alebeierbach/Proyecto-Integrador-PI/README.md

<h1 align="center"><strong>Proyecto Integrador (Tesis)</strong><br></h1>

<p align="center">
  <em>Universidad Nacional de Córdoba</em>
</p>

El trabajo consiste en el diseño e implementación de un prototipo de granja urbana vertical
inteligente a escala reducida, con tres niveles de cultivo en sustrato. El sistema contará con sensado
ambiental (temperatura, humedad, luz), riego por goteo con recirculación, iluminación LED full
espectro, ventilación activa y sistemas para el control de los factores ambientales (sol, lluvia, frío,
calor). El control se realizará mediante microcontrolador, con adquisición y análisis de datos,
orientado a mejorar la eficiencia hídrica y energética.
