alebeierbach/Proyecto-Integrador-PI/Informe/portada.tex

\thispagestyle{empty}

\begin{center}
UNIVERSIDAD NACIONAL DE CÓRDOBA\\
FACULTAD DE CIENCIAS EXACTAS, FÍSICAS Y NATURALES\\
CARRERA INGENIERÍA ELECTRÓNICA\\[2cm]

PROYECTO INTEGRADOR PARA LA OBTENCIÓN DEL TÍTULO DE GRADO\\
INGENIERO ELECTRÓNICO\\[2cm]

{\bfseries\MakeUppercase{\tituloPI}}\\[2cm]

Alumno/s\\
\alumnoA\\
\alumnoB\\[1cm]

Director\\
\directorPI\\[1cm]

Co-Director\\
\codirectorPI\\[2cm]

Córdoba, República Argentina\\
\mesanio
\end{center}
