alebeierbach/Proyecto-Integrador-PI/Informe/anexos/anexo_1.tex

\chapter{Anexo I}
\label{anexo1}

\section*{Título}
\addcontentsline{toc}{section}{Anexo I - Título}

Aquí se incluye material complementario: desarrollos extensos, tablas auxiliares, hojas de datos, código, etc.
