alebeierbach/Proyecto-Integrador-PI/Informe/anexos/anexo_2.tex

\chapter{Anexo II}
\label{anexo2}

\section*{Título}
\addcontentsline{toc}{section}{Anexo II - Título}

Aquí puede incluirse material complementario adicional.
