alebeierbach/Proyecto-Integrador-PI/Informe/paginas/abstract.tex

\chapter*{Abstract}
\addcontentsline{toc}{chapter}{Abstract}

This section must contain the English version of the summary. It should clearly explain the scope of the work, the methodology employed and the general content of the Project. It must not include personal judgments, criticism or interpretations.

\vspace{1cm}

\noindent\textbf{Thematic area:} Communications, Analog electronics

\vspace{0.5cm}

\noindent\textbf{Subjects:} Analog Electronics III, Communications, Electronic Instrumentation

\vspace{0.5cm}

\noindent\textbf{Key words:} tuned filter, impedance matching, resonant circuit, experimental measurements, simulation
