alebeierbach/Proyecto-Integrador-PI/Informe/paginas/director.tex

\thispagestyle{empty}

\begin{center}
UNIVERSIDAD NACIONAL DE CÓRDOBA\\
Facultad de Ciencias Exactas, Físicas y Naturales\\
Escuela de Ingeniería Electrónica
\end{center}

\vspace{1.5cm}

Quien suscribe el Profesor \textbf{COMPLETAR TODOS LOS CAMPOS}, en su carácter de Director del Proyecto Integrador del Estudiante \textbf{COMPLETAR}, denominado:

\vspace{0.5cm}

\begin{center}
\textbf{\tituloPI}
\end{center}

\vspace{0.5cm}

considera que el desarrollo del trabajo se ha completado según lo especificado en la Solicitud de Aprobación de Tema y se encuentra en condiciones de tramitar su defensa.

\vspace{1cm}

A los efectos de quien corresponda, en fecha \underline{\hspace{1cm}}/\underline{\hspace{1cm}}/\underline{\hspace{1cm}}.

\vspace{4cm}

\begin{flushright}
Firma y aclaración del Director
\end{flushright}
