alebeierbach/Proyecto-Integrador-PI/Informe/paginas/lista_simbolos.tex

\chapter*{Lista de símbolos y convenciones}
\addcontentsline{toc}{chapter}{Lista de símbolos y convenciones}

\begin{longtable}{p{3cm} p{10cm}}
$f_0$ & Frecuencia de resonancia o frecuencia central. \\
$BW$ & Ancho de banda. \\
$Q$ & Factor de calidad. \\
$R_g$ & Resistencia del generador o resistencia de entrada. \\
$R_L$ & Resistencia de carga. \\
$L$ & Inductancia. \\
$C$ & Capacitancia. \\
$X_L$ & Reactancia inductiva. \\
$X_C$ & Reactancia capacitiva. \\
\end{longtable}
