alebeierbach/Proyecto-Integrador-PI/Informe/paginas/resumen.tex

\chapter*{Resumen}
\addcontentsline{toc}{chapter}{Resumen}

Este apartado debe contener una descripción clara y concreta del alcance del trabajo. Con su lectura, el lector debe comprender de qué trata el Proyecto Integrador, cómo fue desarrollado y qué aspectos principales aborda. El resumen no debe incluir juicios de valor, interpretaciones ni críticas. Debe tener menos de 400 palabras.

\vspace{1cm}

\noindent\textbf{Área temática:} Comunicaciones, Analógica

\vspace{0.5cm}

\noindent\textbf{Asignaturas:} Electrónica Analógica III, Comunicaciones, Instrumentación Electrónica

\vspace{0.5cm}

\noindent\textbf{Palabras claves:} filtro sintonizado, adaptación de impedancias, circuito resonante, mediciones experimentales, simulación
