alebeierbach/Proyecto-Integrador-PI/Informe/paginas/resumo.tex

\chapter*{Resumo}
\addcontentsline{toc}{chapter}{Resumo}

Esta seção deve conter a versão em português do resumo. O texto deve informar claramente o alcance do trabalho, a metodologia utilizada e os principais aspectos do Projeto Integrador.

\vspace{1cm}

\noindent\textbf{Área temática:} Comunicações, Analógica

\vspace{0.5cm}

\noindent\textbf{Assuntos:} Eletrônica Analógica III, Comunicações, Instrumentação Eletrônica

\vspace{0.5cm}

\noindent\textbf{Palavras chaves:} filtro sintonizado, adaptação de impedâncias, circuito ressonante, medições experimentais, simulação
