alebeierbach/Proyecto-Integrador-PI/Informe/paginas/tribunal.tex

\thispagestyle{empty}

\begin{center}
UNIVERSIDAD NACIONAL DE CÓRDOBA\\
Facultad de Ciencias Exactas, Físicas y Naturales\\
Escuela de Ingeniería Electrónica
\end{center}

\vspace{1.5cm}

El Tribunal Evaluador reunido en este acto y luego de haber aprobado la Solicitud de Aprobación de Tema y efectuado las distintas instancias de correcciones del Informe del Proyecto Integrador para la obtención del Título de Grado ``Ingeniero Electrónico'' y cumpliendo con el Reglamento correspondiente, declaran el Informe Final de/l los estudiante/s: \textbf{COMPLETAR} como ``aceptado sin correcciones'' y la defensa oral aprobada.

Por lo tanto, luego de haber tenido en cuenta los aspectos de evaluación que indica el Reglamento, el Proyecto Integrador se considera aprobado.

\vspace{1cm}

Se firma el Acta de Examen correspondiente y se distribuyen los ejemplares impresos.

\vspace{2cm}

\noindent NOTA:

\vspace{3cm}

\begin{flushright}
Firma y aclaración del Tribunal Evaluador

\vspace{1cm}
Fecha:
\end{flushright}
