alebeierbach/Proyecto-Integrador-PI/Informe/secciones/referencias.tex

\chapter*{Referencias}
\addcontentsline{toc}{chapter}{Referencias}

Aquí van todas las referencias que no sean libros: sitios web, apuntes, hojas de datos, documentación técnica, normas, herramientas de IA, etc.

\begin{thebibliography}{99}

\bibitem{ejemplorecurso} Autor o institución. \textit{Título del recurso}. Recuperado de: URL. Fecha de acceso: dd/mm/aaaa.

\bibitem{openai2026} OpenAI. (2026). ChatGPT \textnormal{[modelo de inteligencia artificial]. Recuperado de: https://openai.com/. Consulta realizada para asistencia de redacción y estructura del documento. Prompt utilizado: "COMPLETAR CON LO QUE SE PREGUNTÓ".}

\bibitem{ejemplodatasheet} Fabricante. \textit{Nombre de la hoja de datos}. Recuperado de: URL. Fecha de acceso: dd/mm/aaaa.

\bibitem{roosteralex2022} roosteralex8214 (2022). \textit{Portable Washing Machine Drain Hose Holder}. Printables. Recuperado de: https://www.printables.com/model/128387-portable-washing-machine-drain-hose-holder/files

\end{thebibliography}
