alebeierbach/Proyecto-Integrador-PI/Informe/anexos/anexo_pi.tex

\chapter{Anexo del Proyecto Integrador}
\label{anexoPI}

\section*{Solicitud de Aprobación de Tema}
\addcontentsline{toc}{section}{Solicitud de Aprobación de Tema}

Aquí va la SAT presentada y aprobada. Deben retirarse los datos personales y firmas del Director, Co-director/es y Estudiante/s.

\section*{Informes mensuales}
\addcontentsline{toc}{section}{Informes mensuales}

Aquí van los informes mensuales ordenados por fecha. Debe retirarse todo dato personal y firmas.
