alebeierbach/Proyecto-Integrador-PI/Informe/capitulos/02_marco_teorico.tex

\chapter{Título del marco teórico}

Un párrafo con la descripción del contenido, lo que espera encontrar el lector.

\section{Conceptos fundamentales}
Aquí se desarrollan los conceptos teóricos más importantes vinculados con el trabajo.

\section{Desarrollo teórico}
Esta sección debe contener el desarrollo conceptual realizado por el alumno, basado en bibliografía y contenidos de la carrera.

\subsection{Modelo teórico}
Puede incluir ecuaciones como:
\begin{equation}
    f_0=\frac{1}{2\pi\sqrt{LC}}
\end{equation}

\subsection{Relaciones relevantes}
\begin{equation}
    Q=\frac{f_0}{BW}
\end{equation}

\section{Síntesis del capítulo}
Incluir un breve cierre del capítulo, enlazando con el desarrollo metodológico posterior.
