alebeierbach/Proyecto-Integrador-PI/Informe/secciones/conclusiones.tex

\chapter*{Conclusiones}
\addcontentsline{toc}{chapter}{Conclusiones}

Las conclusiones deben tener una redacción clara, concreta y directa. No deben ser un resumen del trabajo.

\section*{Resultados obtenidos en relación con la SAT}
\addcontentsline{toc}{section}{Resultados obtenidos en relación con la SAT}

Aquí se discute el grado de cumplimiento de los objetivos planteados inicialmente.

\section*{Conclusión general}
\addcontentsline{toc}{section}{Conclusión general}

Redactar aquí la conclusión principal del trabajo.

\section*{Aporte a la ingeniería o al campo de conocimiento}
\addcontentsline{toc}{section}{Aporte a la ingeniería o al campo de conocimiento}

Describir el aporte técnico, metodológico o académico realizado.

\section*{Limitaciones y trabajos futuros}
\addcontentsline{toc}{section}{Limitaciones y trabajos futuros}

Incluir limitaciones del estudio, mejoras posibles y continuidad del trabajo.
