alebeierbach/Proyecto-Integrador-PI/Informe/Imagenes/imagen2.jpeg

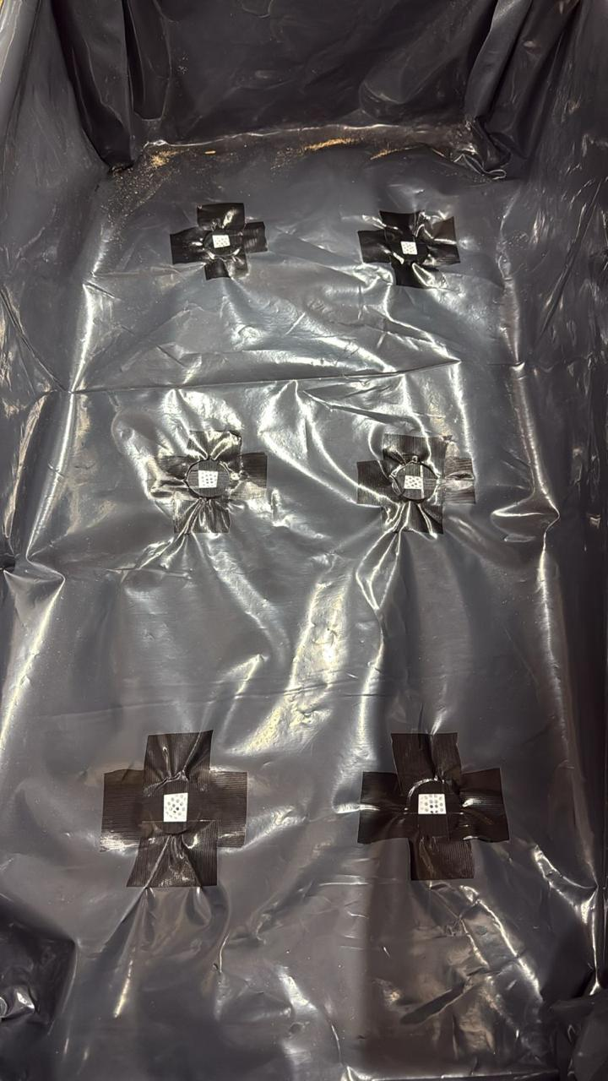
Informe/Imagenes/imagen2.jpeg
