alebeierbach/Proyecto-Integrador-PI/Informe/Imagenes/imagen10.jpeg

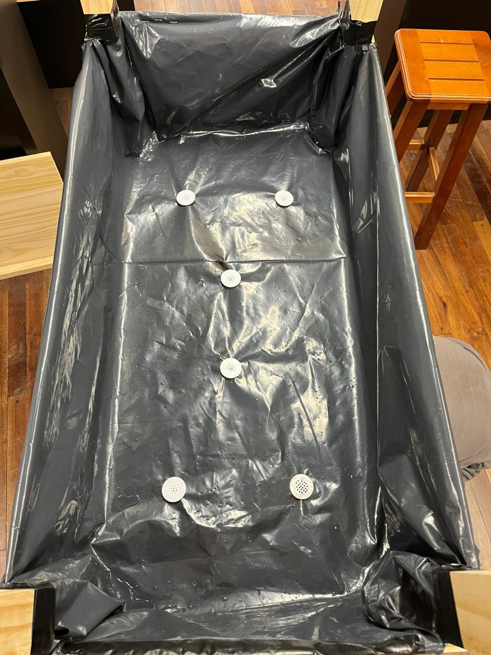
Informe/Imagenes/imagen10.jpeg
