alebeierbach/Proyecto-Integrador-PI/Informe/Imagenes/imagen11.jpeg

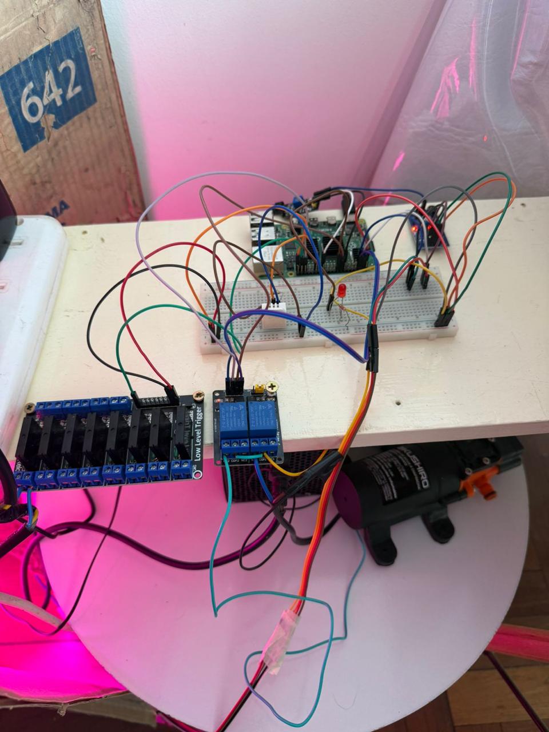
Informe/Imagenes/imagen11.jpeg
