alebeierbach/Proyecto-Integrador-PI/Informe/Imagenes/imagen12.jpeg

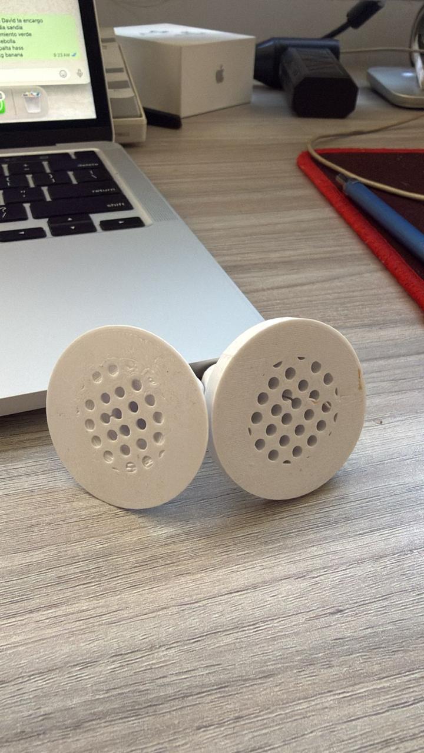
Informe/Imagenes/imagen12.jpeg
