alebeierbach/Proyecto-Integrador-PI/Informe/Imagenes/imagen13.jpeg

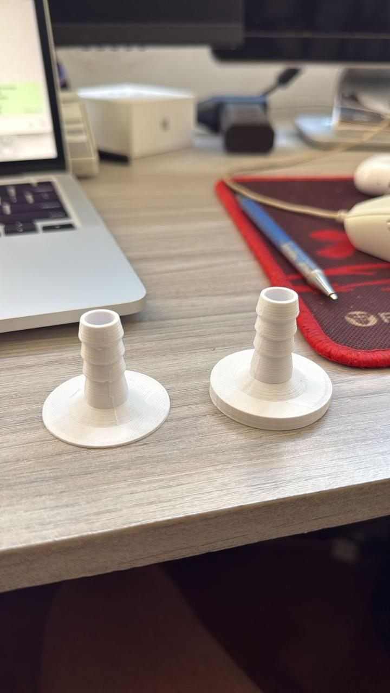
Informe/Imagenes/imagen13.jpeg
