alebeierbach/Proyecto-Integrador-PI/Informe/Imagenes/Plantaciones/Cosecha23-021.JPG

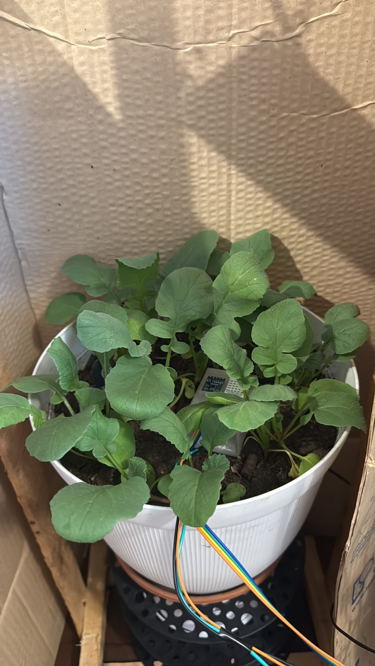
Informe/Imagenes/Plantaciones/Cosecha23-021.JPG
