alebeierbach/Proyecto-Integrador-PI/Informe/Imagenes/Plantaciones/Cosecha23-025.JPG

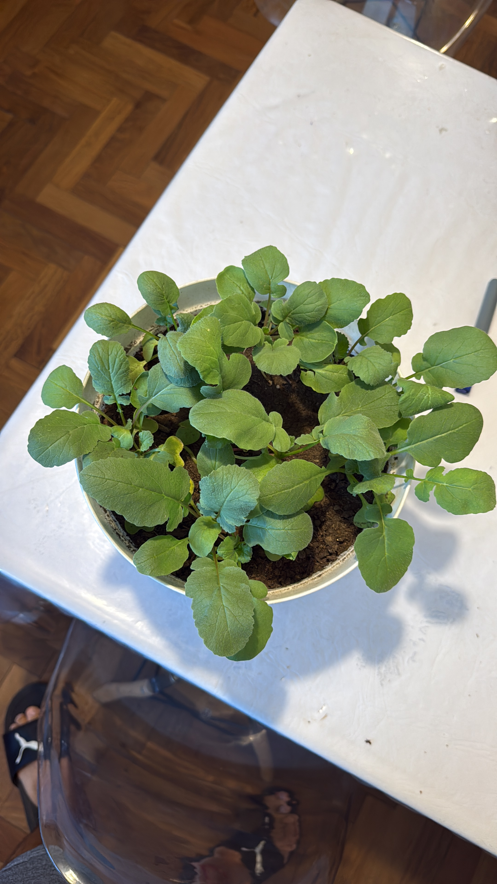
Informe/Imagenes/Plantaciones/Cosecha23-025.JPG
