alebeierbach/Proyecto-Integrador-PI/Informe/Imagenes/Plantaciones/Cosecha23-026.JPG

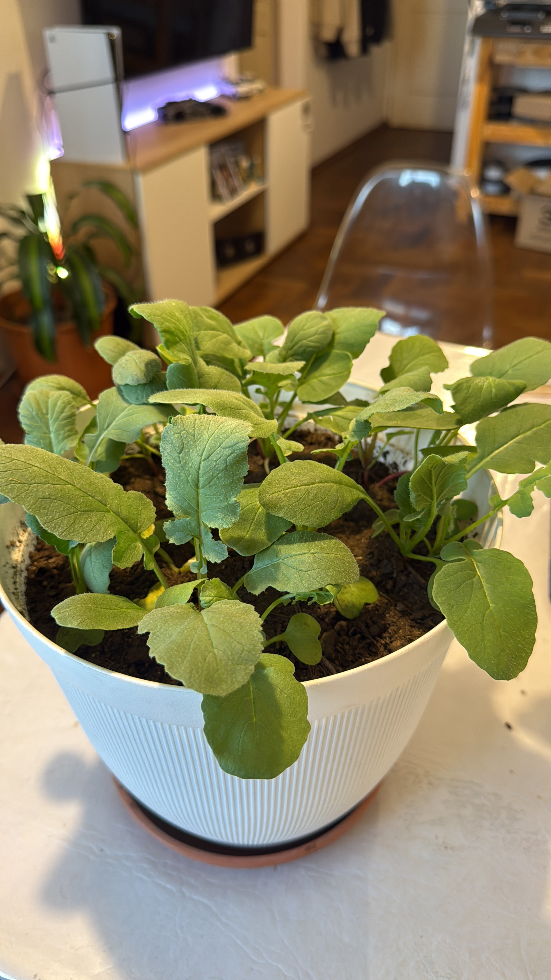
Informe/Imagenes/Plantaciones/Cosecha23-026.JPG
