alebeierbach/Proyecto-Integrador-PI/Informe/Imagenes/Plantaciones/Cosecha23-027.JPG

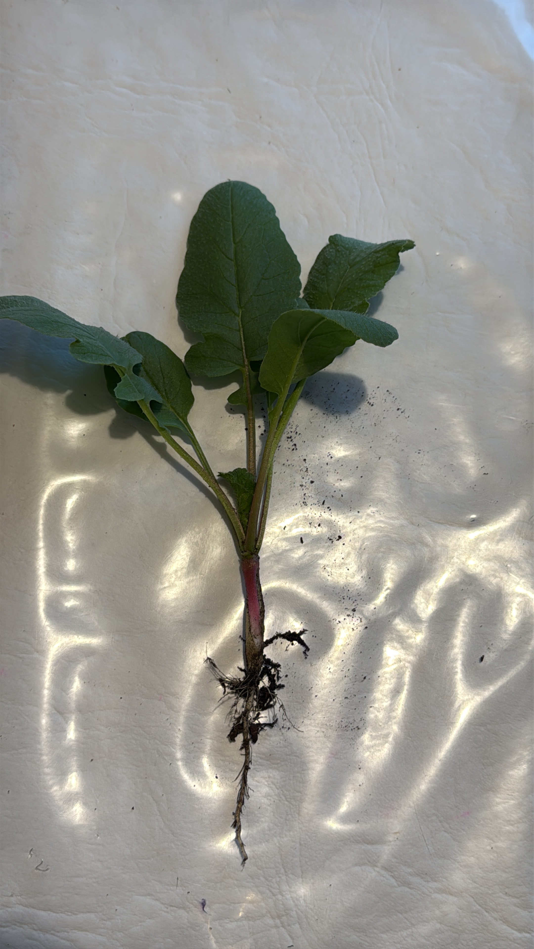
Informe/Imagenes/Plantaciones/Cosecha23-027.JPG
