alebeierbach/Proyecto-Integrador-PI/Informe/Imagenes/Plantaciones/PHOTO-2026-01-28-15-14-25.jpg

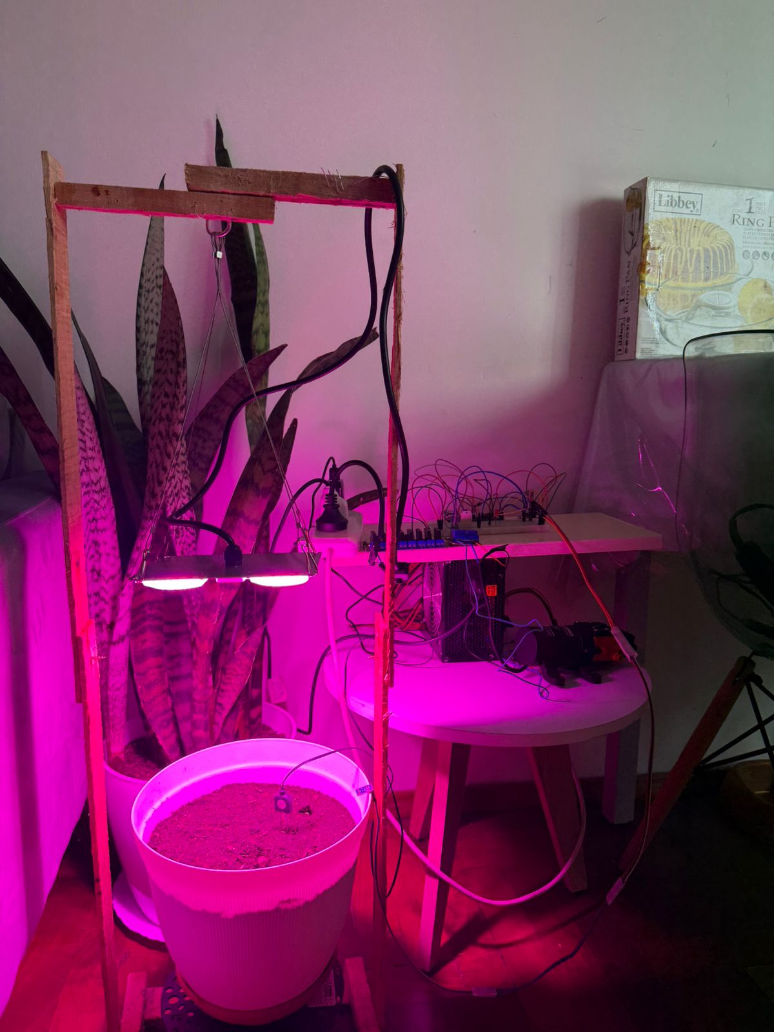
Informe/Imagenes/Plantaciones/PHOTO-2026-01-28-15-14-25.jpg
