alebeierbach/Proyecto-Integrador-PI/Informe/Imagenes/Plantaciones/PHOTO-2026-02-06-19-06-24.jpg

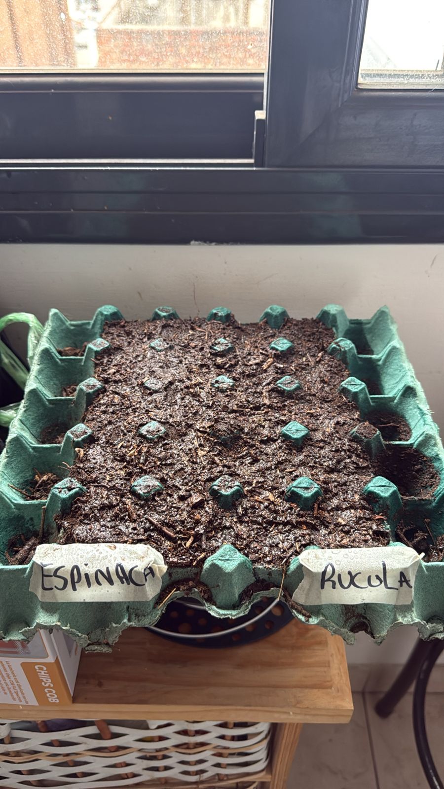
Informe/Imagenes/Plantaciones/PHOTO-2026-02-06-19-06-24.jpg
