alebeierbach/Proyecto-Integrador-PI/Informe/Imagenes/Plantaciones/PHOTO-2026-03-11-15-31-00.jpg

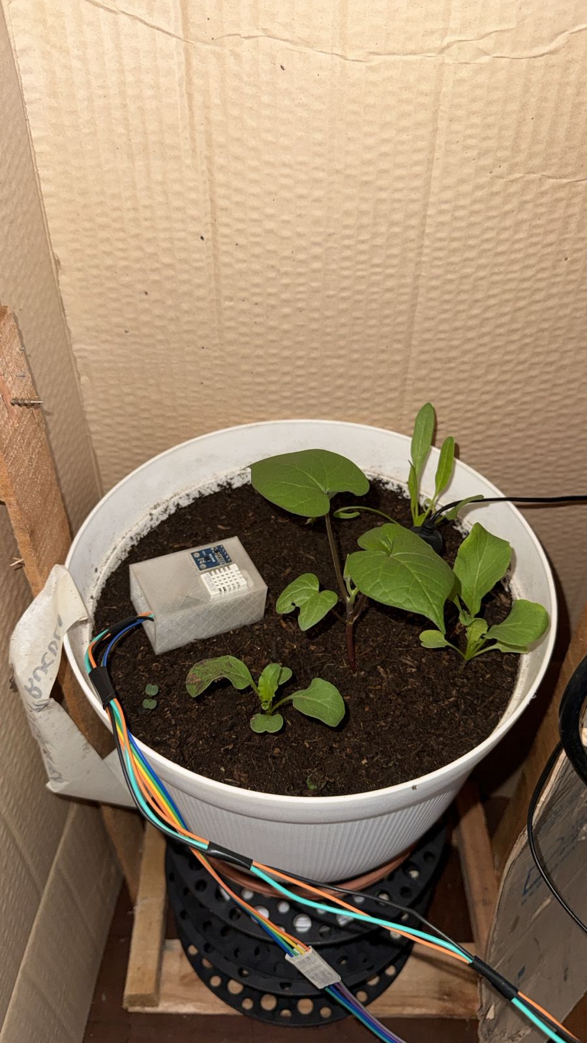
Informe/Imagenes/Plantaciones/PHOTO-2026-03-11-15-31-00.jpg
