alebeierbach/Proyecto-Integrador-PI/Informe/Imagenes/Plantaciones/PHOTO-2026-03-14-17-08-41.jpg

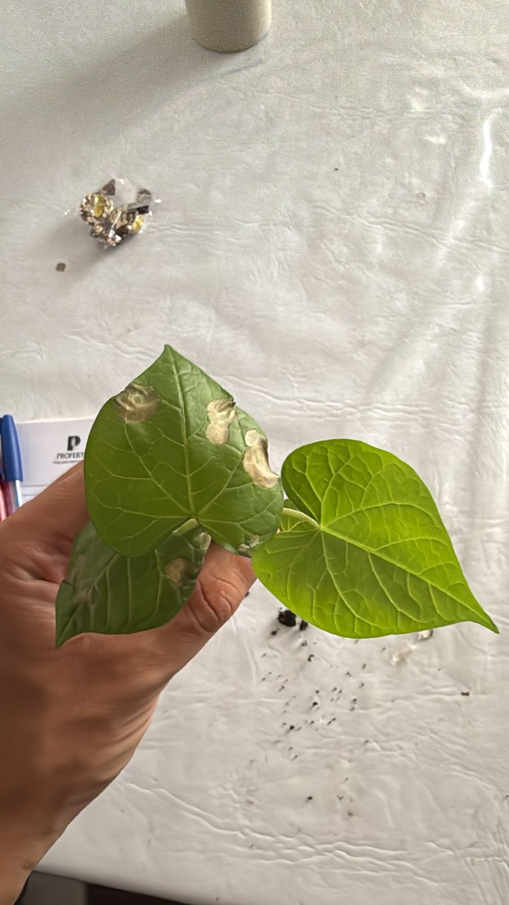
Informe/Imagenes/Plantaciones/PHOTO-2026-03-14-17-08-41.jpg
