alebeierbach/Proyecto-Integrador-PI/Informe/Imagenes/Plantaciones/PHOTO-2026-03-17-10-24-21.jpg

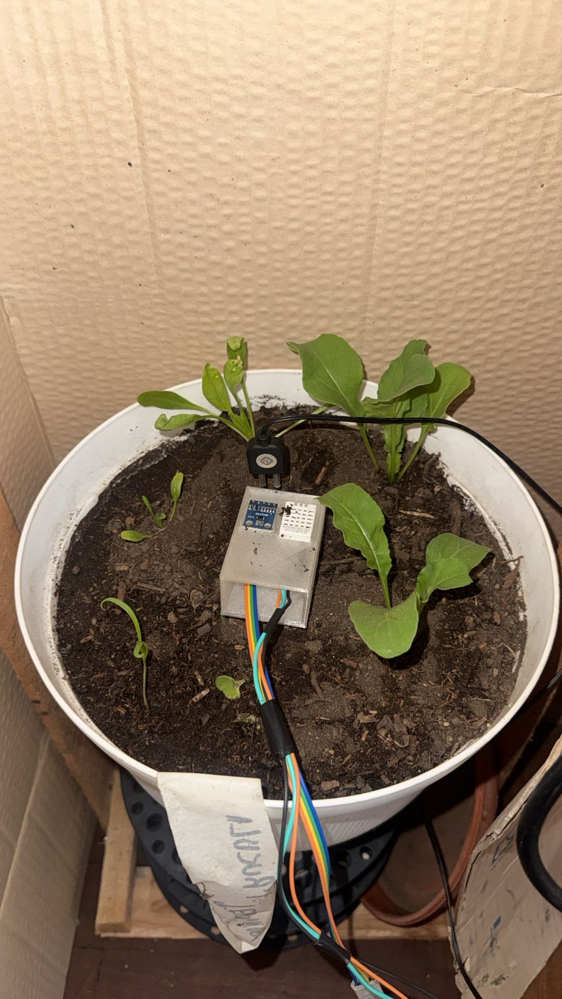
Informe/Imagenes/Plantaciones/PHOTO-2026-03-17-10-24-21.jpg
