alebeierbach/Proyecto-Integrador-PI/Informe/Imagenes/Plantaciones/PHOTO-2026-03-23-00-21-39.jpg

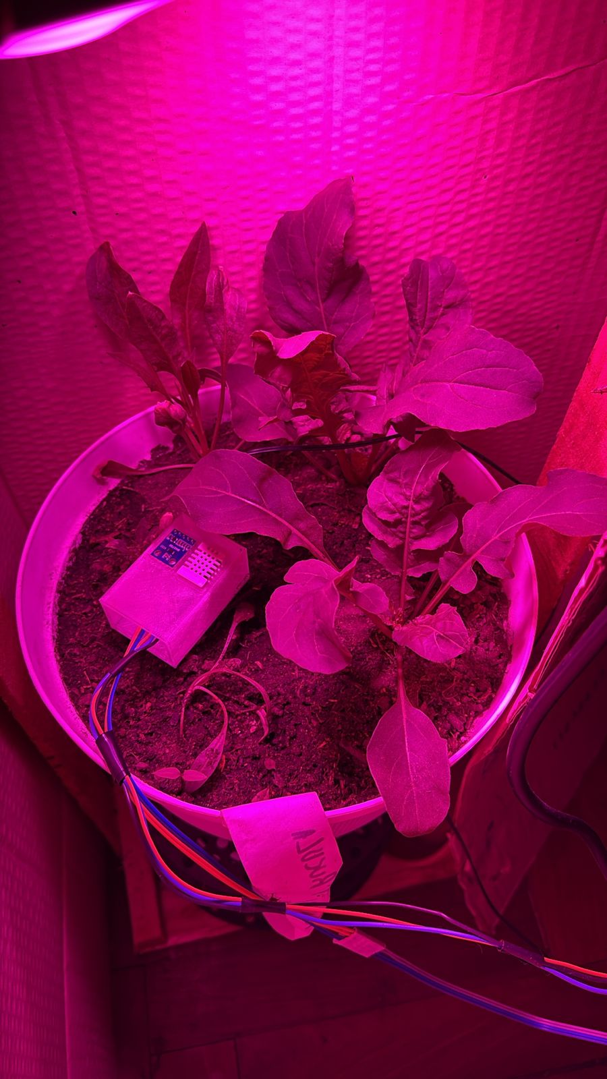
Informe/Imagenes/Plantaciones/PHOTO-2026-03-23-00-21-39.jpg
