alebeierbach/Proyecto-Integrador-PI/Informe/Imagenes/Plantaciones/PHOTO-2026-03-24-09-35-10.jpg

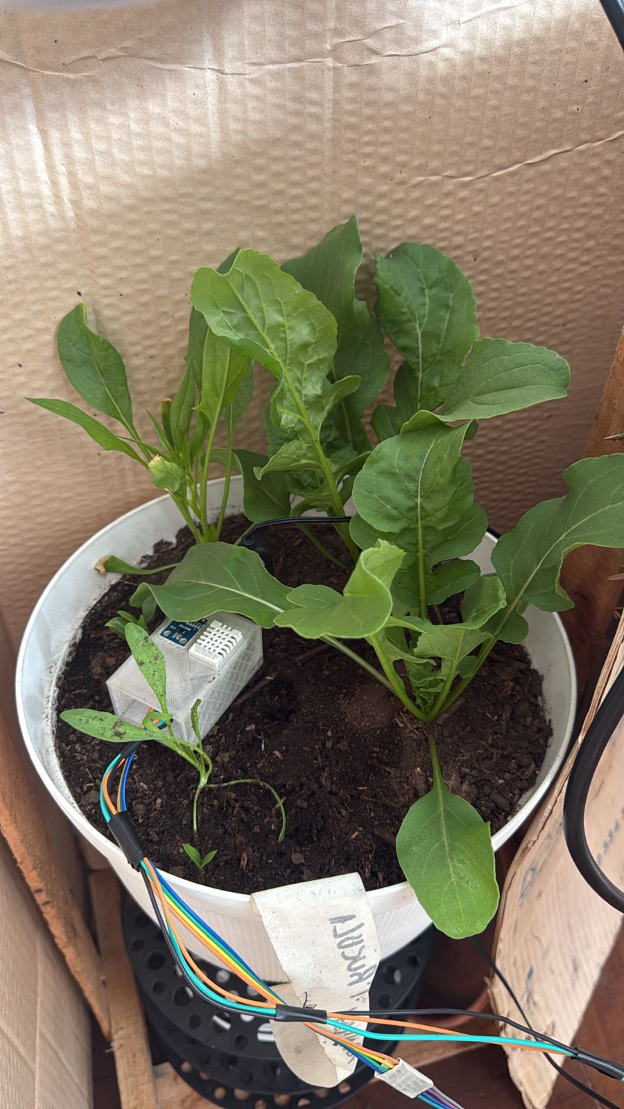
Informe/Imagenes/Plantaciones/PHOTO-2026-03-24-09-35-10.jpg
