alebeierbach/Proyecto-Integrador-PI/Informe/Imagenes/Plantaciones/PHOTO-2026-03-25-11-57-21.jpg

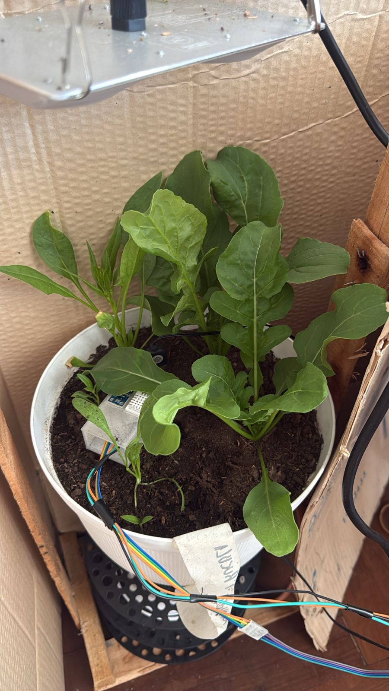
Informe/Imagenes/Plantaciones/PHOTO-2026-03-25-11-57-21.jpg
