alebeierbach/Proyecto-Integrador-PI/Informe/Imagenes/Plantaciones/PHOTO-2026-04-01-11-06-17.jpg

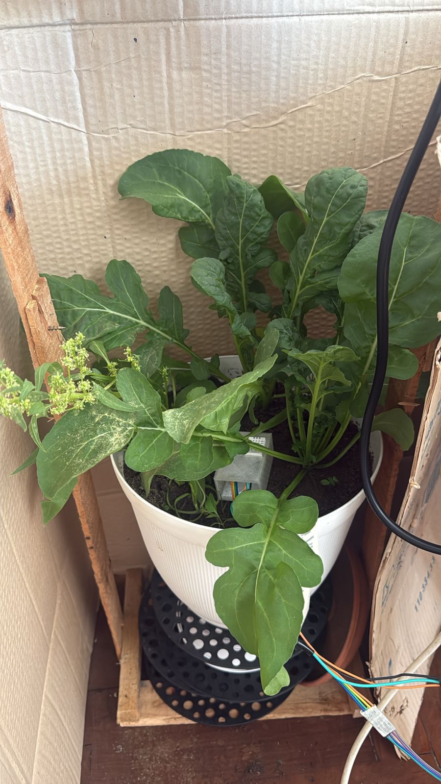
Informe/Imagenes/Plantaciones/PHOTO-2026-04-01-11-06-17.jpg
