alebeierbach/Proyecto-Integrador-PI/Informe/secciones/graficos_telemetria.png

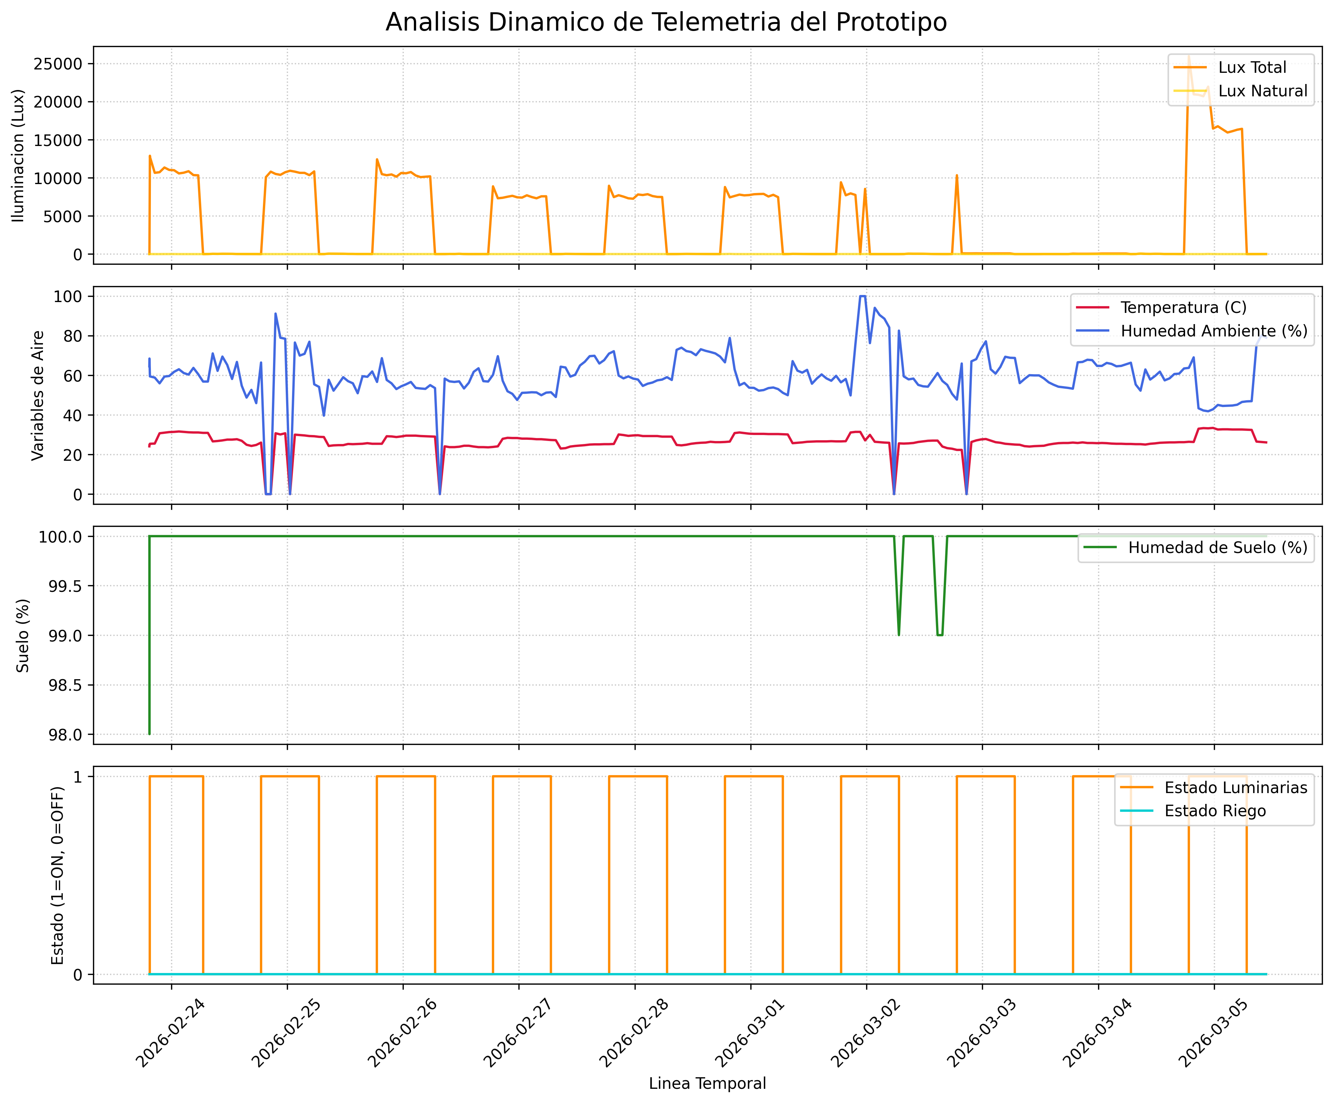
Informe/secciones/graficos_telemetria.png
