alebeierbach/Proyecto-Integrador-PI/Diseños3D/SoporteManguera.stl

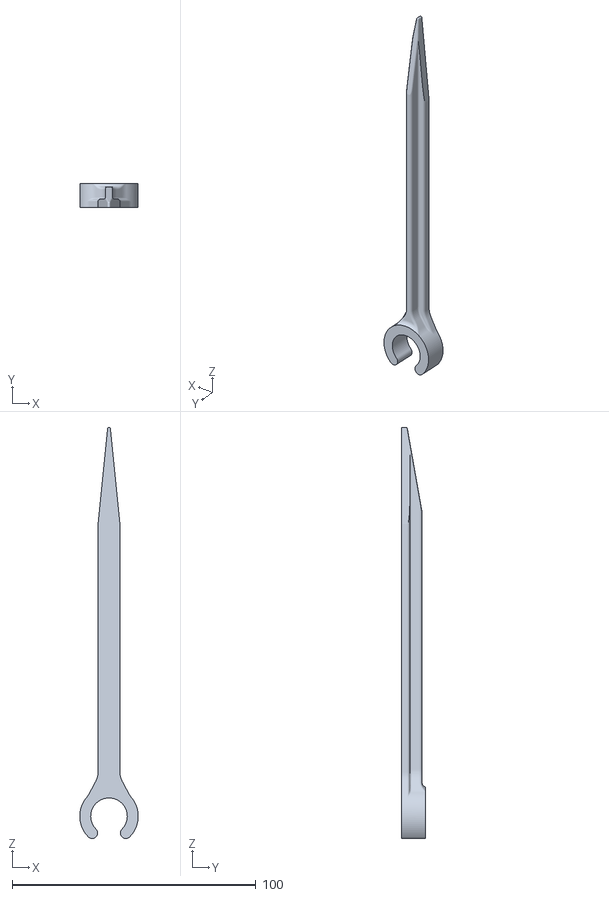
[picture p54: CAD file, 2026-03-11]
Diseños3D/SoporteManguera.stl
24.0 x 10.0 x 168.7
