alebeierbach/Proyecto-Integrador-PI/Diseños3D/FiltradoMacetaPIv3.stl

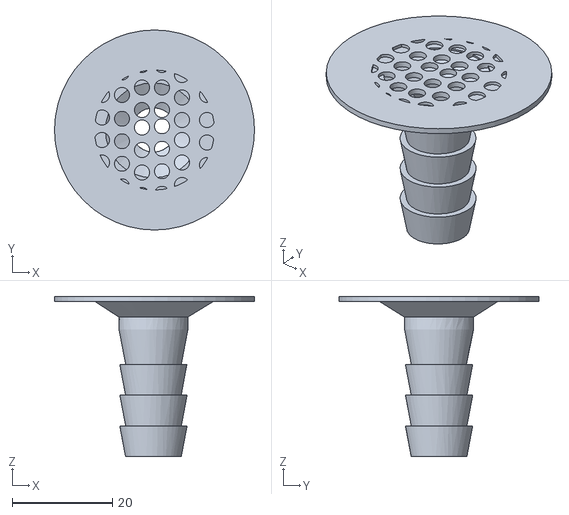
[picture p56: CAD file, 2026-03-11]
Diseños3D/FiltradoMacetaPIv3.stl
40.0 x 40.0 x 32.0
