alebeierbach/Proyecto-Integrador-PI/Diseños3D/AcopleDoble.stl

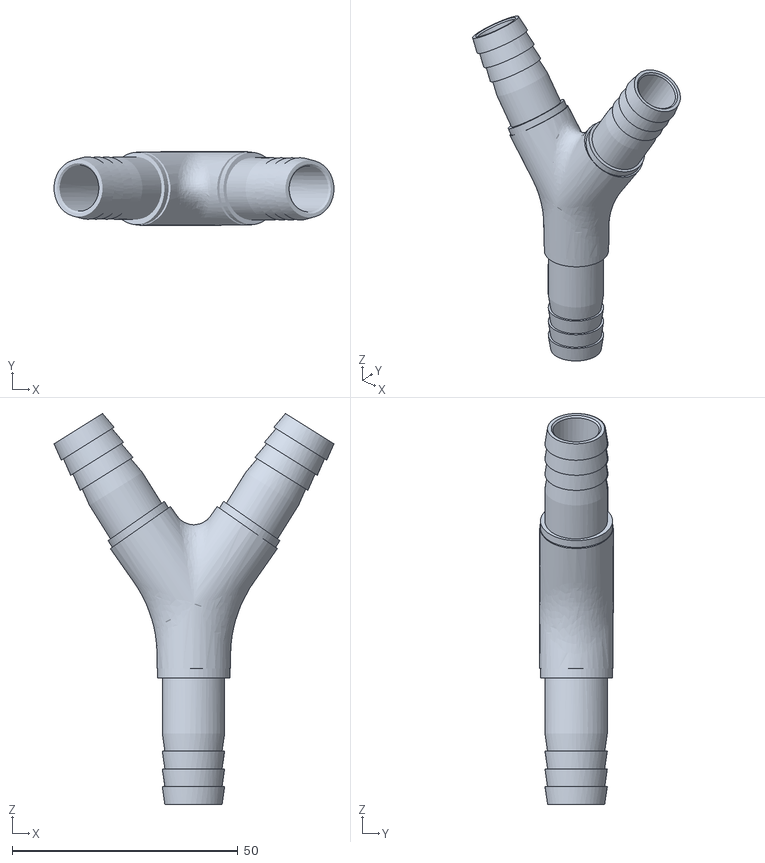
[picture p57: CAD file, 2026-03-11]
Diseños3D/AcopleDoble.stl
62.1 x 16.3 x 86.7
