alebeierbach/Proyecto-Integrador-PI/Diseños3D/FiltradoMacetaPIv2.stl

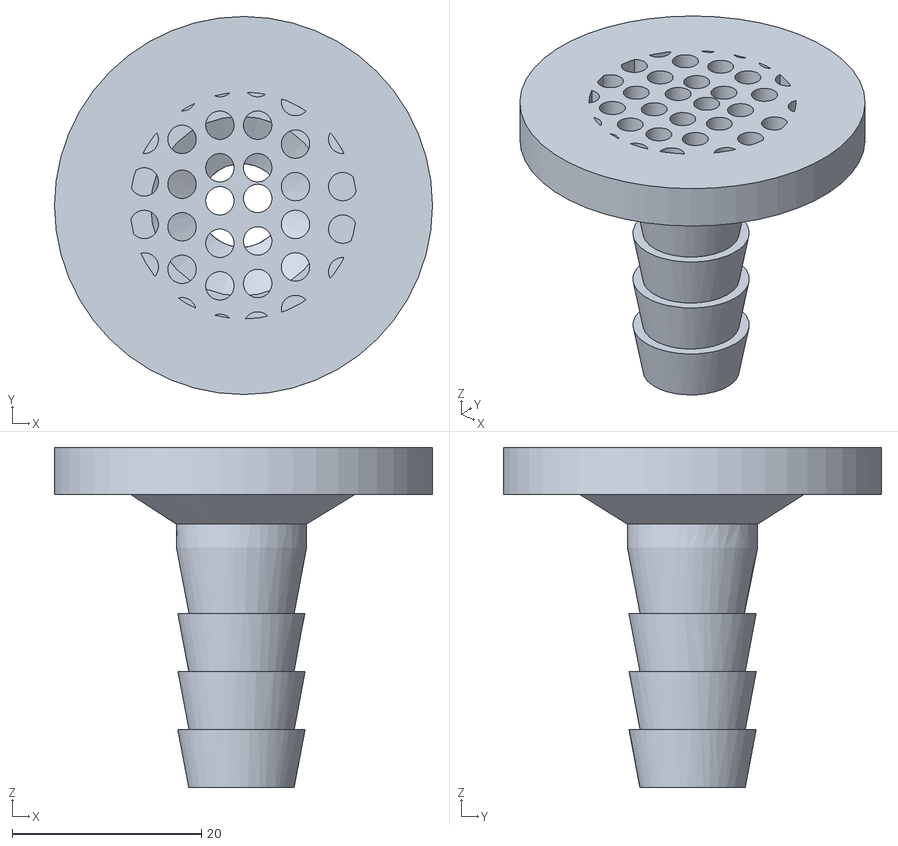
[picture p58: CAD file, 2026-03-11]
Diseños3D/FiltradoMacetaPIv2.stl
40.0 x 40.0 x 36.0
