alebeierbach/Proyecto-Integrador-PI/Diseños3D/Macetas.stl

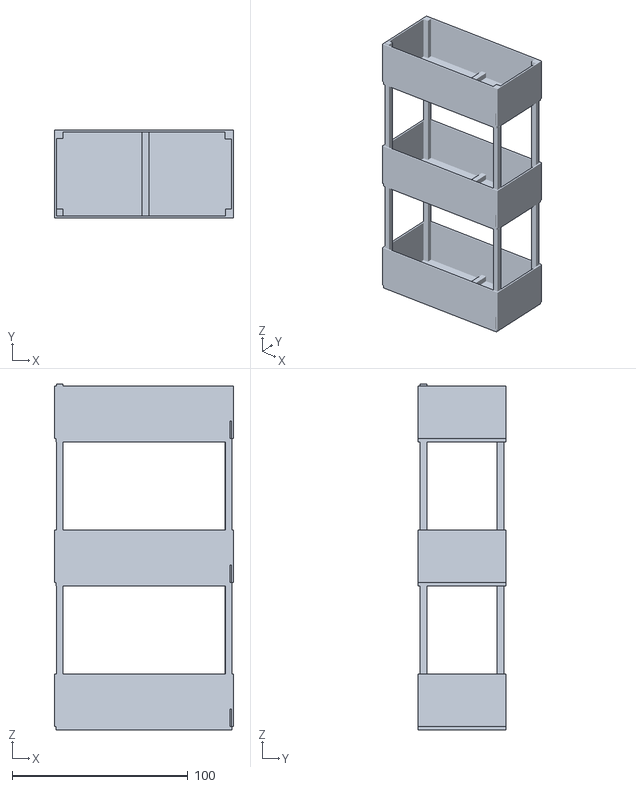
[picture p59: CAD file, 2026-01-10]
Diseños3D/Macetas.stl
102.0 x 50.0 x 197.0
