alebeierbach/Proyecto-Integrador-PI/Diseños3D/Maceta.stl

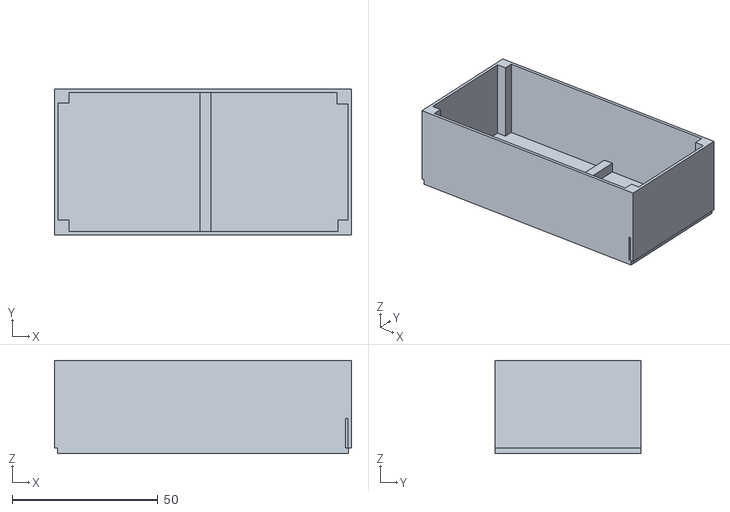
[picture p60: CAD file, 2026-01-10]
Diseños3D/Maceta.stl
102.0 x 50.0 x 32.0
