alebeierbach/Proyecto-Integrador-PI/Informe/secciones/resultados.tex

\chapter*{Resultados}
\addcontentsline{toc}{chapter}{Resultados}

Aquí se describen los resultados obtenidos luego de todo el proceso, a modo de resumen y haciendo referencia a lo desarrollado anteriormente. Inicialmente se mostrara el crecimiento del cultivo, luego los datos recopilados por los sensores durante la fase de crecimiento y finalmente se hara una breve conclusion de los resultados obtenidos durante esa etapa. Cabe destacar que las imagenes fueron tomadas en momentos donde se considero necesario, viable u optimo considerando el crecimiento vegetal.

\section{Resultados del prototipo preliminar}
A continuación, se presentan los resultados derivados de los ensayos con el prototipo inicial de pruebas. Tal como se introdujo en los apartados previos, esta primera aproximación física tuvo como propósito fundamental validar la viabilidad operativa del sistema y comprobar la correcta interacción de sus componentes antes de proceder al diseño definitivo. Por ser una etapa temprana del desarrollo, aun no estaba habilitada la bomba de agua.

\subsection{Primera prueba}
En este apartado se mostraran los resultados obtenidos correspondiente a la primera plantacion del prototipo. Donde primero se vera la evolucion del cultivo y luego se presentaran los graficos de los parametros mas relevantes del sistema.

Inicialmente se realizo la plantacion de las primeras semillas de rabanito, a continuacion se mostrara la evidencia fotografica en orden cronologico:
\begin{figure}[htbp]
    \centering
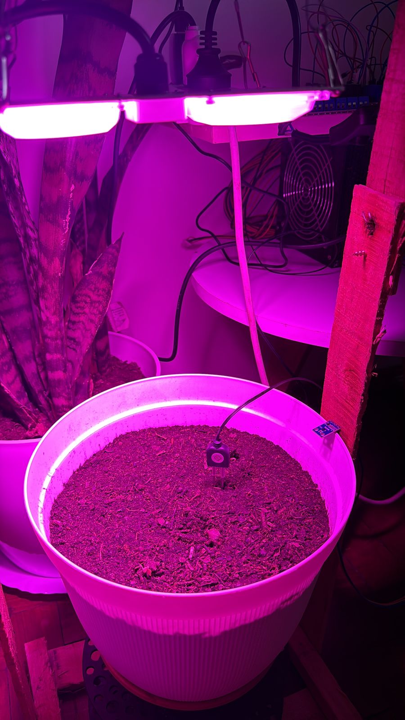
[picture p61: Informe/Imagenes/Plantaciones/PHOTO-2026-01-28-15-14-25 2.jpg]
    
    \caption{Primera plantacion: 28/01/26}
    \label{fig:placeholder1}
\end{figure}
\begin{figure}[H]
    \centering
    \begin{minipage}{0.48\textwidth}
        \centering
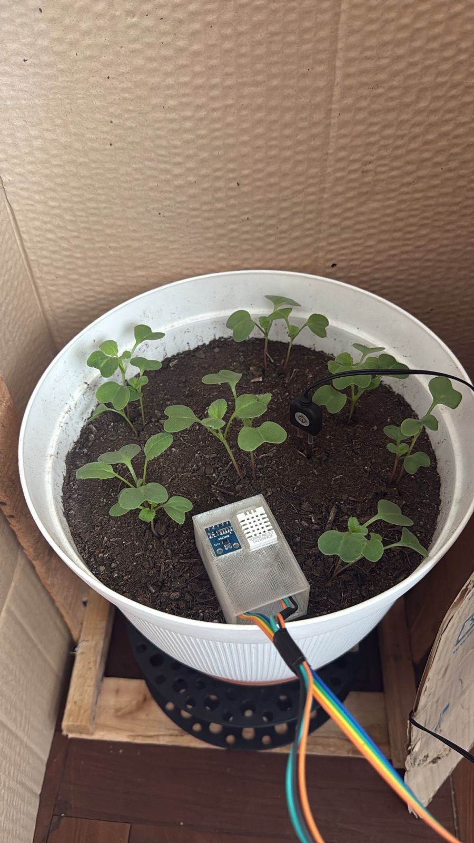
[picture p62: Informe/Imagenes/Plantaciones/PHOTO-2026-02-05-12-14-55.jpg]
        
    \end{minipage}
    \hfill
    \begin{minipage}{0.48\textwidth}
        \centering
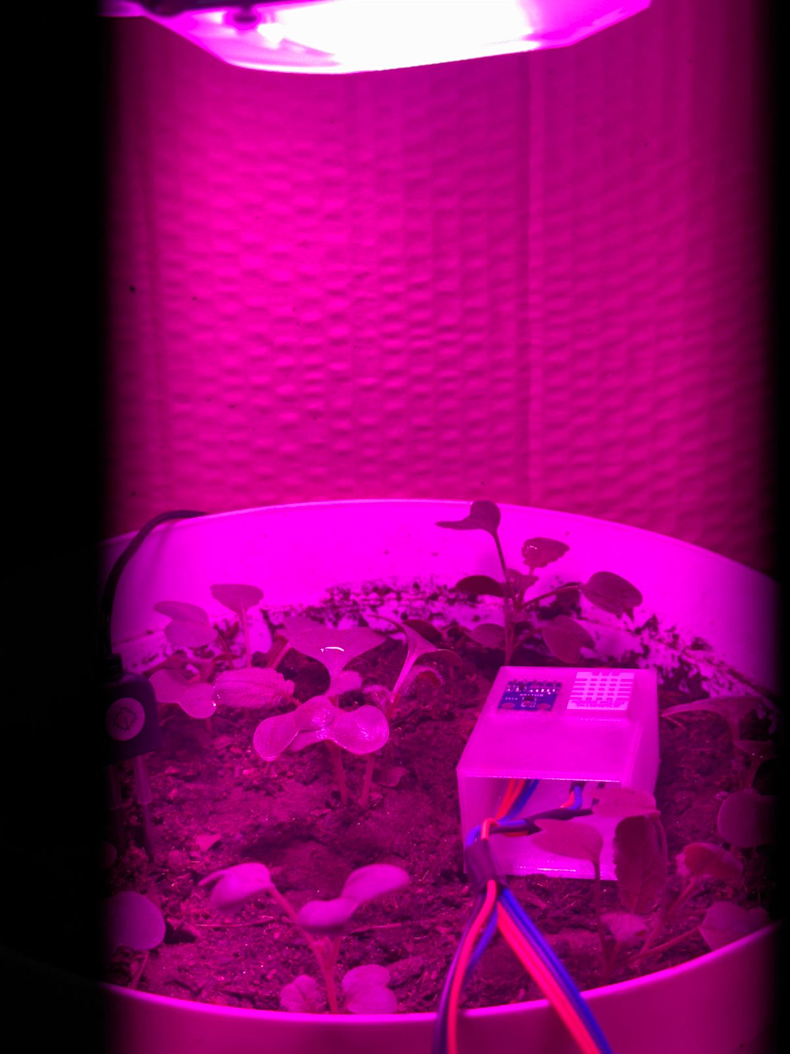
[picture p63: Informe/Imagenes/Plantaciones/PHOTO-2026-02-05-12-57-14.jpg]
        
    \end{minipage}
    \caption{Fecha de la foto: 05/02/26}
\end{figure}

\begin{figure}[H]
    \centering
    \begin{minipage}{0.48\textwidth}
        \centering
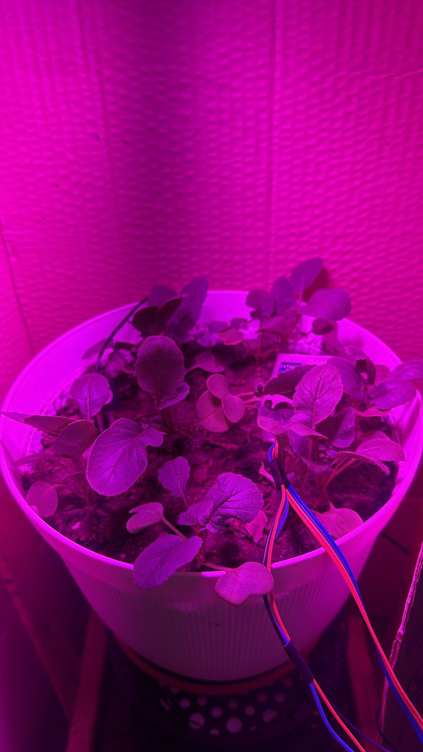
[picture p64: Informe/Imagenes/Plantaciones/PHOTO-2026-02-17-11-02-15.jpg]
        
    \end{minipage}
    \hfill
    \begin{minipage}{0.48\textwidth}
        \centering
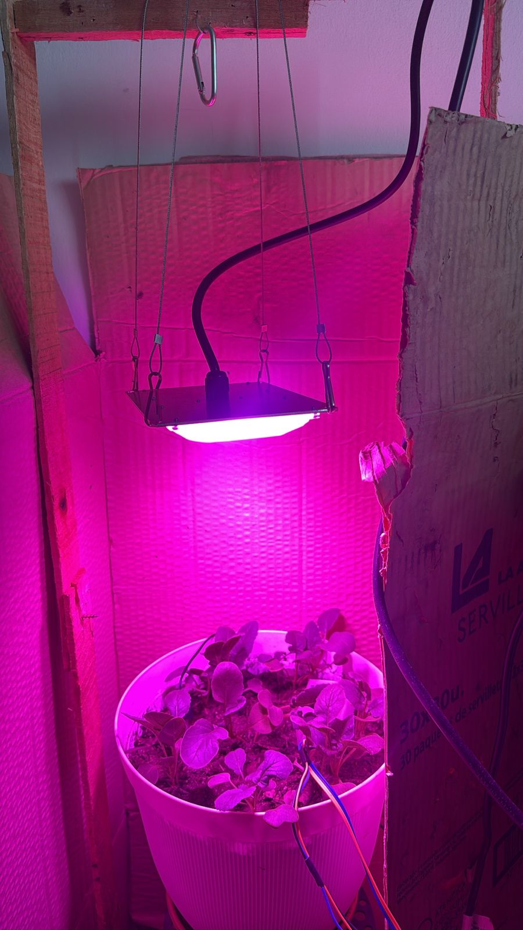
[picture p65: Informe/Imagenes/Plantaciones/PHOTO-2026-02-17-11-02-20.jpg]
        
    \end{minipage}
    \caption{Fecha de la foto: 17/02/26}
\end{figure}

\begin{figure}[htbp]
    \centering
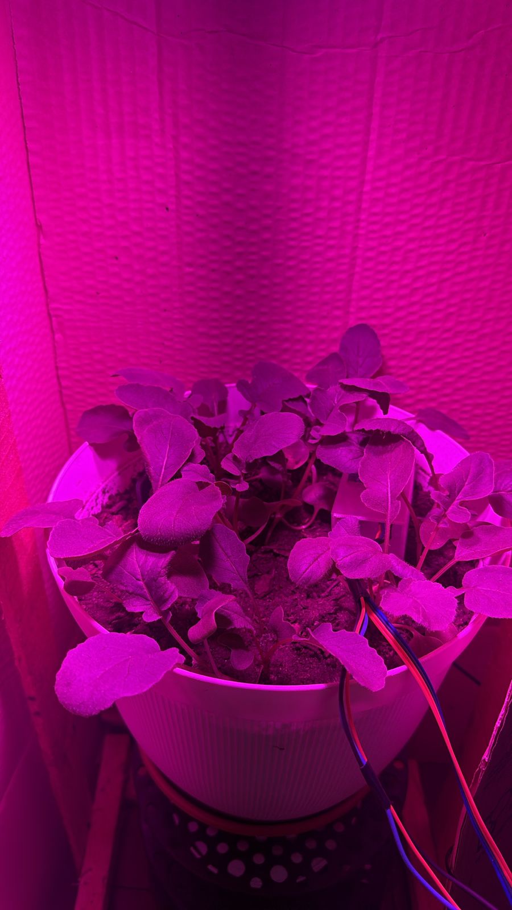
[picture p66: Informe/Imagenes/Plantaciones/PHOTO-2026-02-19-15-40-45.jpg]
    
    \caption{Fecha de la foto: 19/02/26}
    \label{fig:placeholder1}
\end{figure}

\begin{figure}[H]
    \centering
    \begin{minipage}{0.31\textwidth}
        \centering
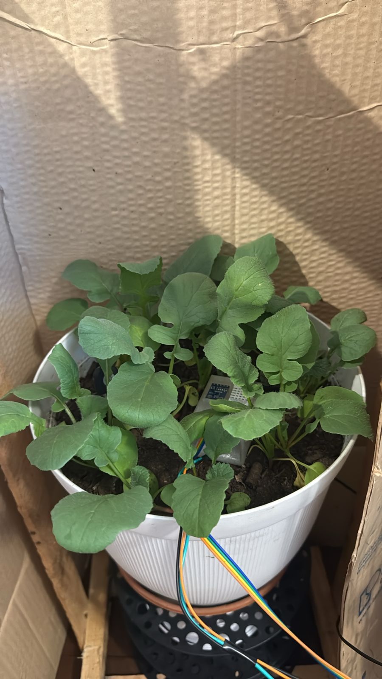
[picture p67: Informe/Imagenes/Plantaciones/PHOTO-2026-02-23-18-32-17.jpg]
        
    \end{minipage}
    \hfill
    \begin{minipage}{0.31\textwidth}
        \centering
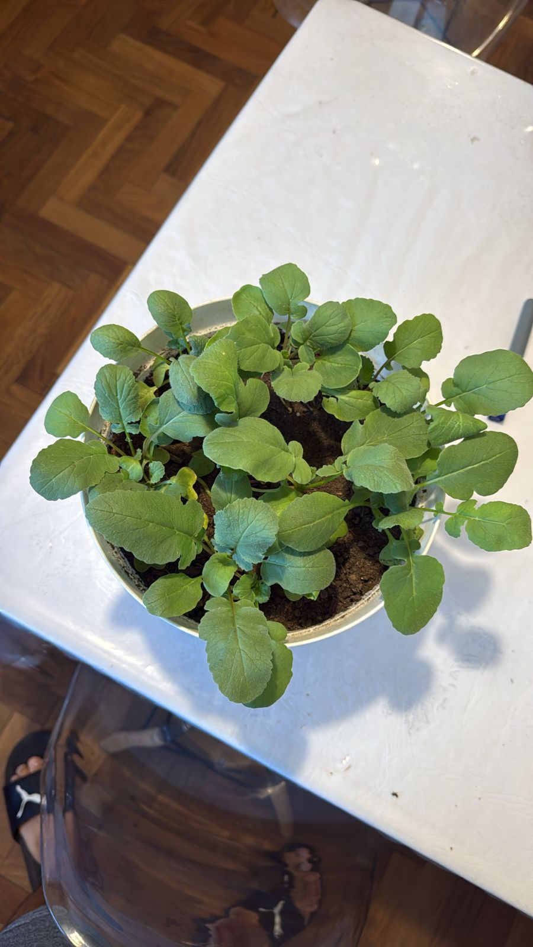
[picture p68: Informe/Imagenes/Plantaciones/PHOTO-2026-02-23-18-36-37.jpg]
        
    \end{minipage}
    \hfill
    \begin{minipage}{0.31\textwidth}
        \centering
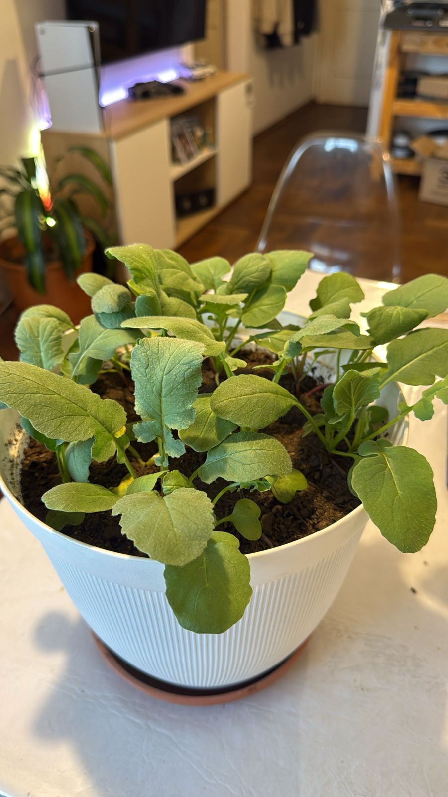
[picture p69: Informe/Imagenes/Plantaciones/PHOTO-2026-02-23-18-36-45.jpg]
        
    \end{minipage}
    \caption{Fecha de la foto: 23/02/26}
\end{figure}

En la figura subsiguiente se exhiben los resultados obtenidos tras un período aproximado de un mes de desarrollo. Como se evidencia en las capturas, se produjo una inhibición en el desarrollo completo del hipocótilo del rabanito, fenómeno atribuible a las elevadas temperaturas registradas en el entorno ambiental. Los niveles térmicos cercanos a los 30 grados Celsius actúan como un estresor que desencadena la inducción floral prematura, forzando a la especie vegetal a desviar sus recursos energéticos hacia las estructuras reproductivas en detrimento del engrosamiento de la raíz. Adicionalmente, se determinó que la restricción en el volumen radicular, impuesta por las dimensiones reducidas del contenedor inicial, limitó la expansión del cultivo. Pese a estos factores la planta tuvo un correcto desarrollo y evoluciono como debia ser, confirmando la efectividad del sistema. Luego, el rendimiento de la cosecha presentó las siguientes características:
\begin{figure}[htbp]
    \centering
    
    \caption{Cosecha: 23/02/26}
    \label{fig:placeholder1}
\end{figure}

A continuación, se presentan las representaciones gráficas de las series temporales correspondientes a las variables críticas para el desarrollo y sostenimiento del cultivo. Estas ilustraciones permiten analizar el comportamiento dinámico del sistema y evaluar la estabilidad frente a las perturbaciones del entorno.

\begin{figure}[H]
    \centering
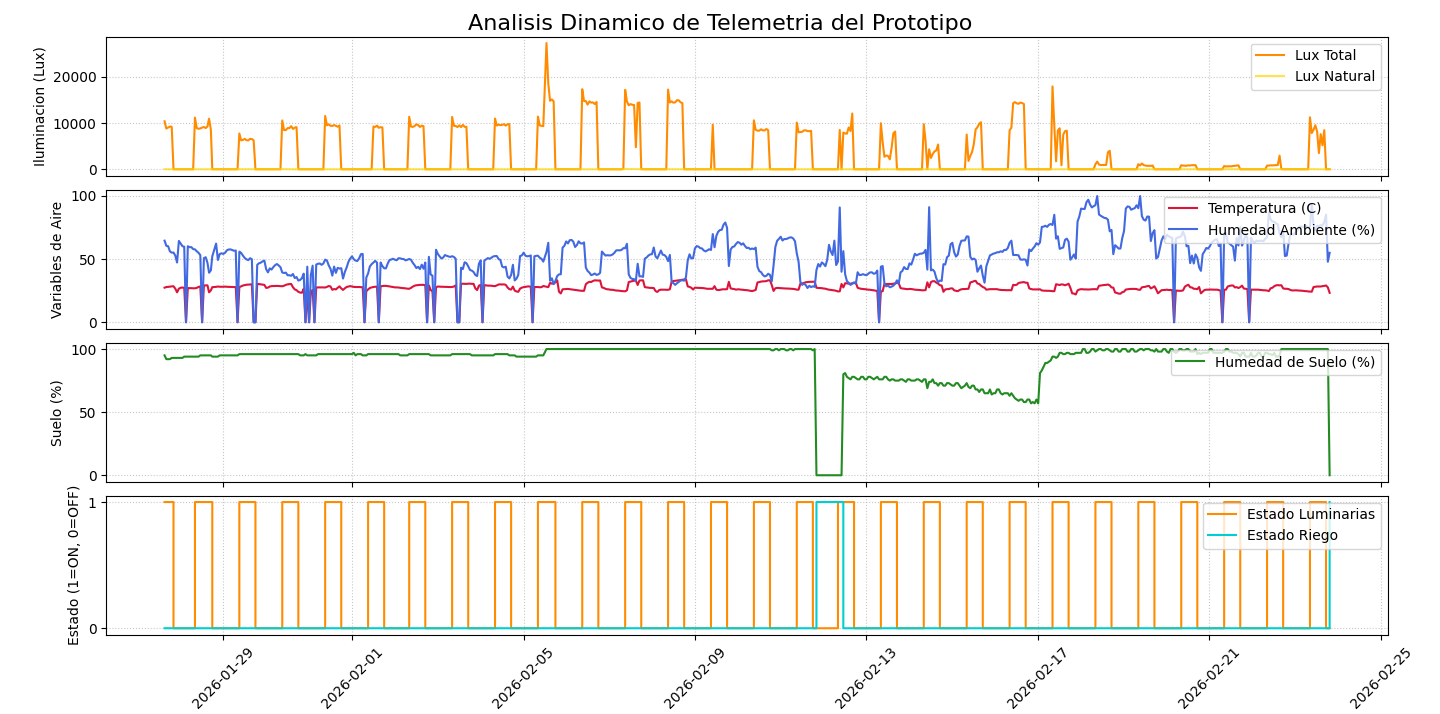
[picture p70: Informe/Imagenes/GraficoPrimerMedicion.png]
    
    \caption{Series temporales de la telemetría del prototipo: variables lumínicas, ambientales, de suelo y estados de los actuadores.}
    \label{fig:graficos_telemetria}
\end{figure}
A partir de las series temporales presentadas, es posible determinar el fotoperíodo diario al que fue sometido el cultivo, identificándose claramente las fases de activación lumínica y los intervalos de oscuridad correspondientes al ciclo nocturno. La atenuación progresiva registrada en los niveles de iluminancia máxima no responde a una degradación de las luminarias, sino al fenómeno de oclusión óptica derivado del propio crecimiento de las especies vegetales; al incrementar el índice de área foliar, las hojas obstruyeron de forma directa la trayectoria del flujo fotónico hacia la superficie activa del sensor. Respecto al microclima, se constata un régimen térmico persistente cercano a los 30 grados Celsius, factor crítico que aceleró la inducción floral prematura analizada previamente. En cuanto a la dinámica hídrica, la lectura inicial saturada del 100 por ciento obedeció a una falta de linealización en la etapa preliminar; tras aplicar una recalibración en los umbrales del software, se optimizó la resolución de la medida, permitiendo registrar la curva de secado natural del sustrato y los picos de recuperación inmediata tras los eventos de irrigación. Finalmente, la condición desactivada de la bomba hidráulica durante la mayor parte del ensayo confirma que el riego se ejecutó de forma manual, registrándose un único pulso de activación remota debido a una prueba de validación sobre el algoritmo de control.

\subsection{Segunda prueba}
Tras concluir el primer ciclo de evaluación y aplicar las acciones correctivas pertinentes sobre las vulnerabilidades identificadas en el sistema, se dio inicio a la segunda etapa de experimentación práctica habiendo cultivado rúcula y espinaca. En esta fase, se implementó una estrategia de desplazamiento del fotoperíodo artificial hacia los ciclos nocturnos, aprovechando el descenso natural de la temperatura ambiental durante dicho intervalo. Esta inversión horaria tuvo como propósito mitigar el estrés térmico acumulado en el habitáculo, evitando la inducción floral prematura observada en los ensayos previos y promoviendo un desarrollo vegetativo sostenido. Asimismo, se introdujeron modificaciones en la lógica del software orientadas a optimizar los algoritmos de adquisición y filtrado de señales, logrando una recopilación de datos telemétricos con mayores índices de precisión y estabilidad temporal. Con el propósito de constatar las mejoras funcionales implementadas en el prototipo, se expone a continuación el seguimiento visual que detalla la evolución de las especies vegetales a lo largo de este segundo ensayo:

\begin{figure}[H]
    \centering
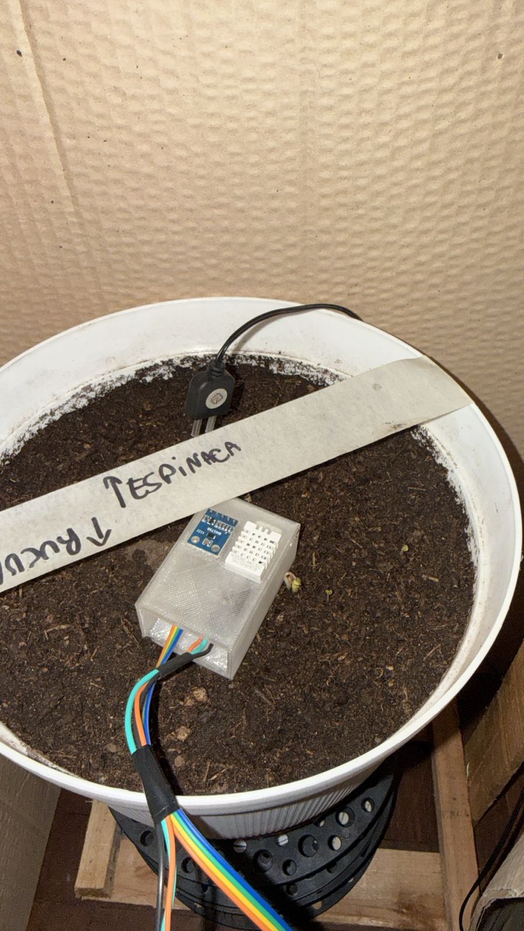
[picture p71: Informe/Imagenes/Plantaciones/PHOTO-2026-02-26-20-17-45.jpg]
    
    \caption{Fecha de la foto: 26/02/26}
    \label{fig:prueba2_26feb}
\end{figure}

\begin{figure}[H]
    \centering
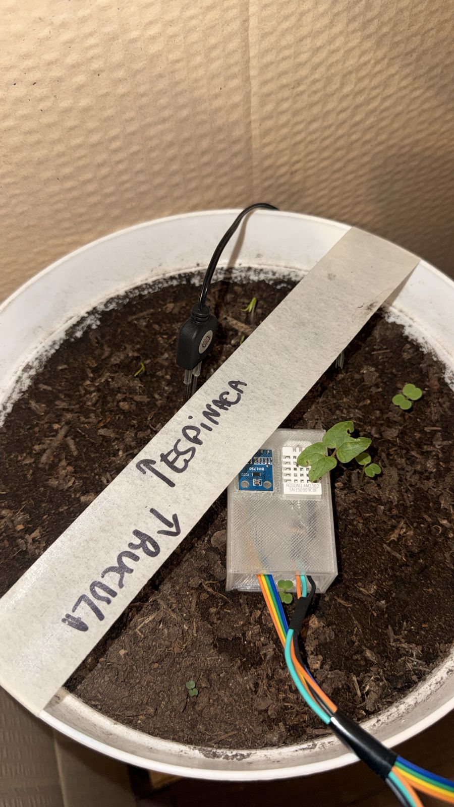
[picture p72: Informe/Imagenes/Plantaciones/PHOTO-2026-02-28-20-01-16.jpg]
    
    \caption{Fecha de la foto: 28/02/26}
    \label{fig:prueba2_28feb}
\end{figure}

\begin{figure}[H]
    \centering
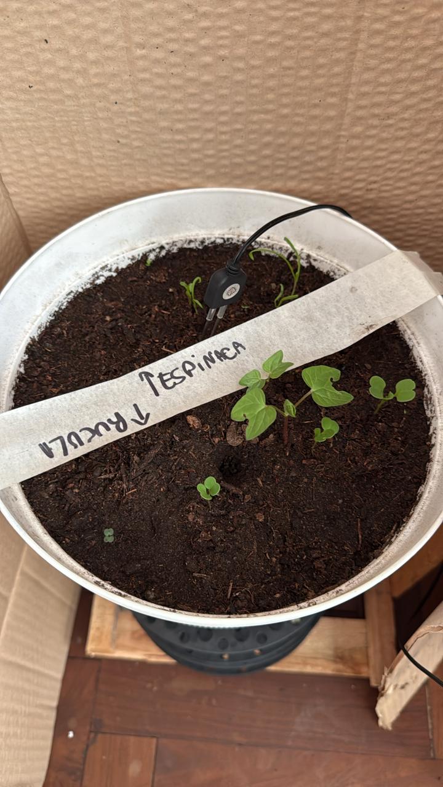
[picture p73: Informe/Imagenes/Plantaciones/PHOTO-2026-03-04-08-08-46.jpg]
    
    \caption{Fecha de la foto: 04/03/26}
    \label{fig:prueba2_04mar}
\end{figure}

\begin{figure}[H]
    \centering
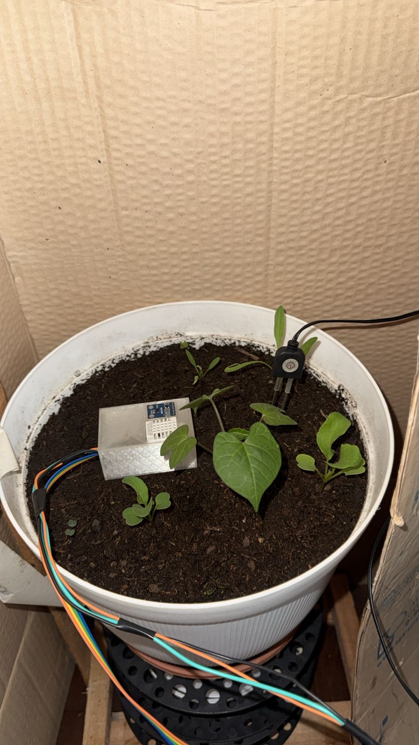
[picture p74: Informe/Imagenes/Plantaciones/PHOTO-2026-03-09-11-18-40.jpg]
    
    \caption{Fecha de la foto: 09/03/26}
    \label{fig:prueba2_09mar}
\end{figure}

Como se constata en el registro fotográfico, el espécimen de mayor volumen biológico corresponde a una planta invasora no introducida de forma voluntaria en el contenedor.

\begin{figure}[H]
    \centering
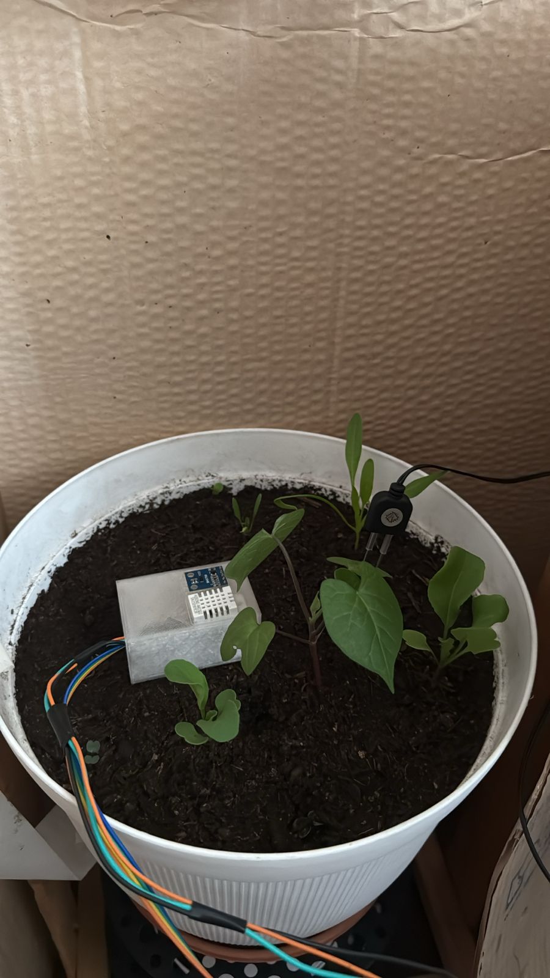
[picture p75: Informe/Imagenes/Plantaciones/PHOTO-2026-03-10-10-13-06.jpg]
    
    \caption{Fecha de la foto: 10/03/26}
    \label{fig:prueba2_10mar}
\end{figure}

Posteriormente fue retirada del contenedor:

\begin{figure}[H]
    \centering
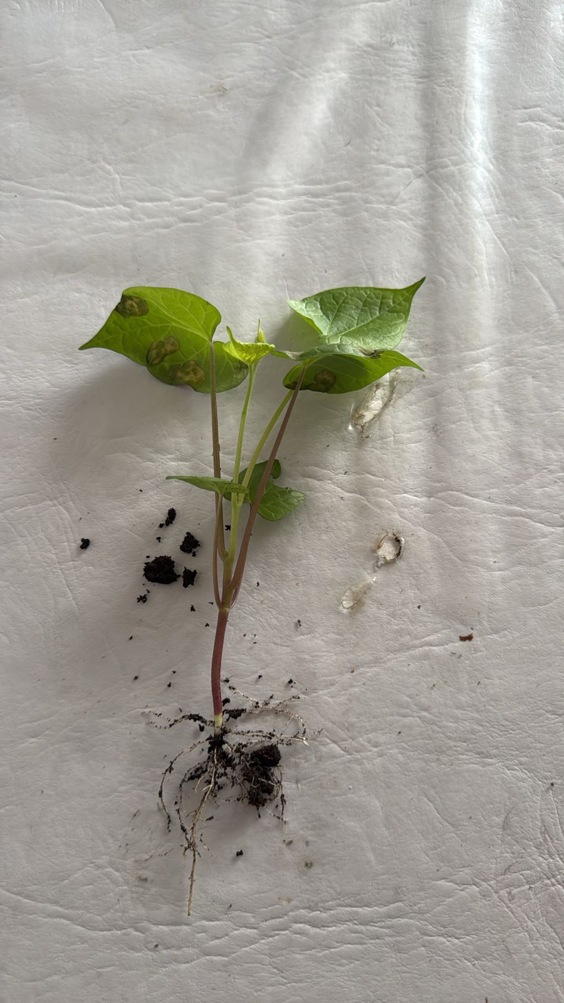
[picture p76: Informe/Imagenes/Plantaciones/PHOTO-2026-03-14-17-08-35.jpg]
    
    \caption{Planta invasora}
    \label{fig:prueba2_invasora}
\end{figure}

\begin{figure}[H]
    \centering
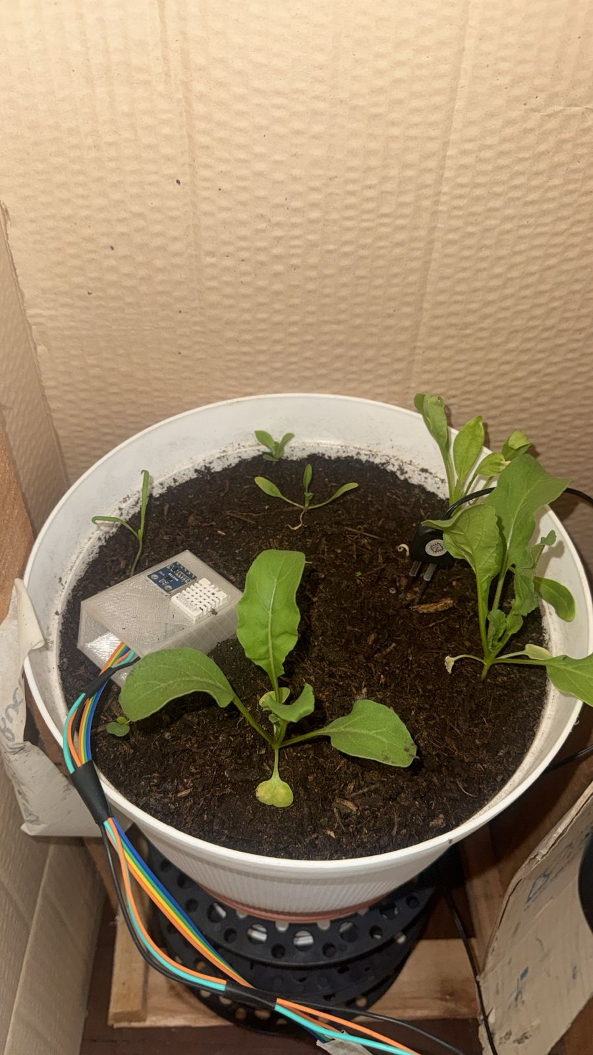
[picture p77: Informe/Imagenes/Plantaciones/PHOTO-2026-03-17-08-46-41.jpg]
    
    \caption{Fecha de la imagen: 17/03/26}
    \label{fig:prueba2_17mar}
\end{figure}

\begin{figure}[H]
    \centering
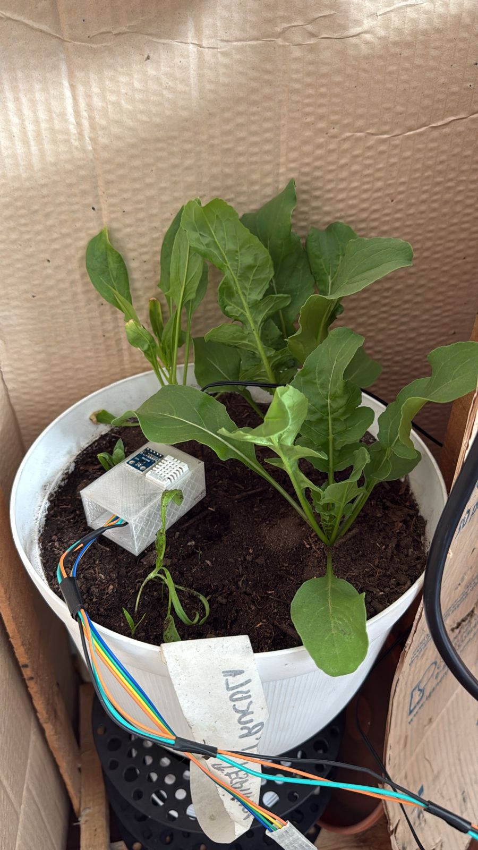
[picture p78: Informe/Imagenes/Plantaciones/PHOTO-2026-03-23-09-53-17.jpg]
    
    \caption{Fecha de la imagen: 23/03/26}
    \label{fig:prueba2_23mar}
\end{figure}

\begin{figure}[H]
    \centering
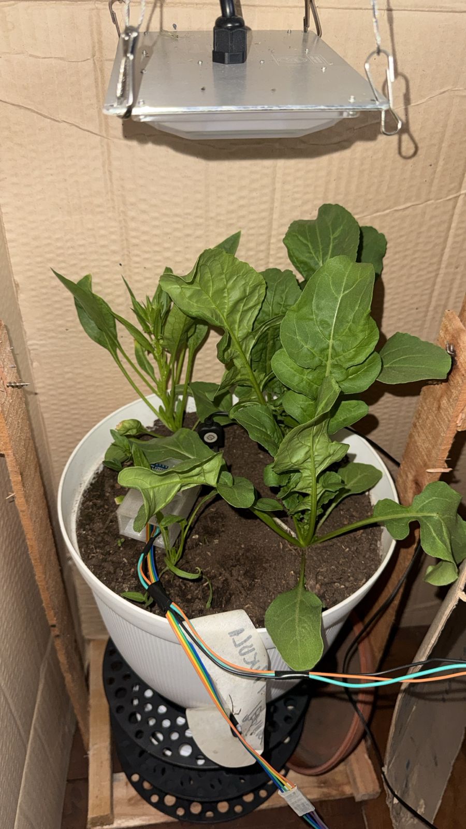
[picture p79: Informe/Imagenes/Plantaciones/PHOTO-2026-03-26-09-30-48.jpg]
    
    \caption{Fecha de la imagen: 26/03/26}
    \label{fig:prueba2_26mar}
\end{figure}

\begin{figure}[H]
    \centering
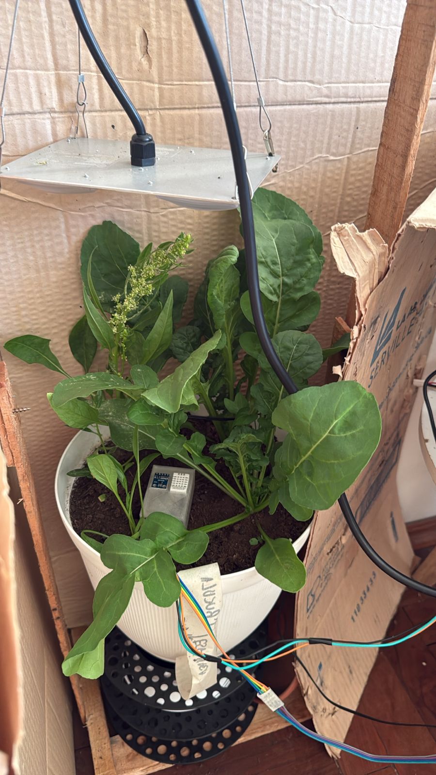
[picture p80: Informe/Imagenes/Plantaciones/PHOTO-2026-03-30-07-52-15.jpg]
    
    \caption{Fecha de la imagen: 30/03/26}
    \label{fig:prueba2_30mar}
\end{figure}

El análisis comparativo del crecimiento revela que la rúcula logró un desarrollo óptimo en las condiciones ensayadas, en contraste con la espinaca, cuyo crecimiento fue limitado debido a una floración anticipada o espigamiento. Este fenómeno fisiológico fue causado por las altas temperaturas térmicas del habitáculo, las cuales forzaron al cultivo a priorizar su ciclo reproductivo y destinar sus recursos metabólicos a la formación de estructuras florales. Este direccionamiento de la energía redujo significativamente el volumen final de la canopia vegetal. En la figura subsiguiente se exhiben los resultados obtenidos tras un período aproximado de un mes y dos semanas de desarrollo:
\begin{figure}[H]
    \centering
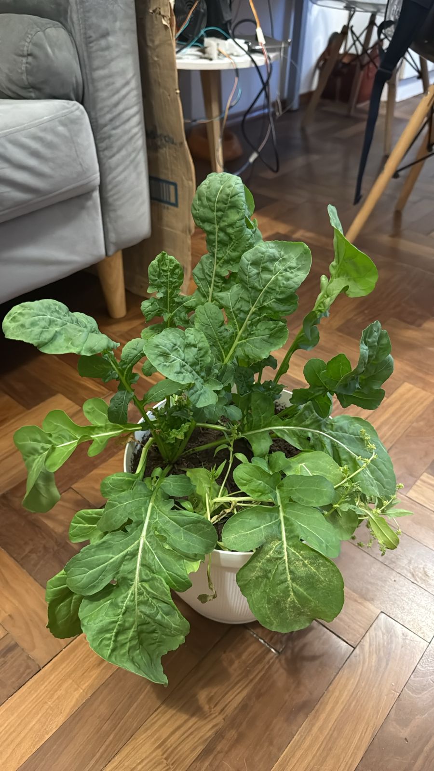
[picture p81: Informe/Imagenes/Plantaciones/PHOTO-2026-04-06-08-23-04.jpg]
    
    \caption{Fecha de la imagen: 06/04/26}
    \label{fig:prueba2_06abr}
\end{figure}

A continuación, se presentan las representaciones gráficas de las series temporales correspondientes a las variables críticas para el desarrollo y sostenimiento del cultivo. Estas ilustraciones permiten analizar el comportamiento dinámico del sistema y evaluar la estabilidad frente a las perturbaciones del entorno.
\begin{figure}[H]
    \centering
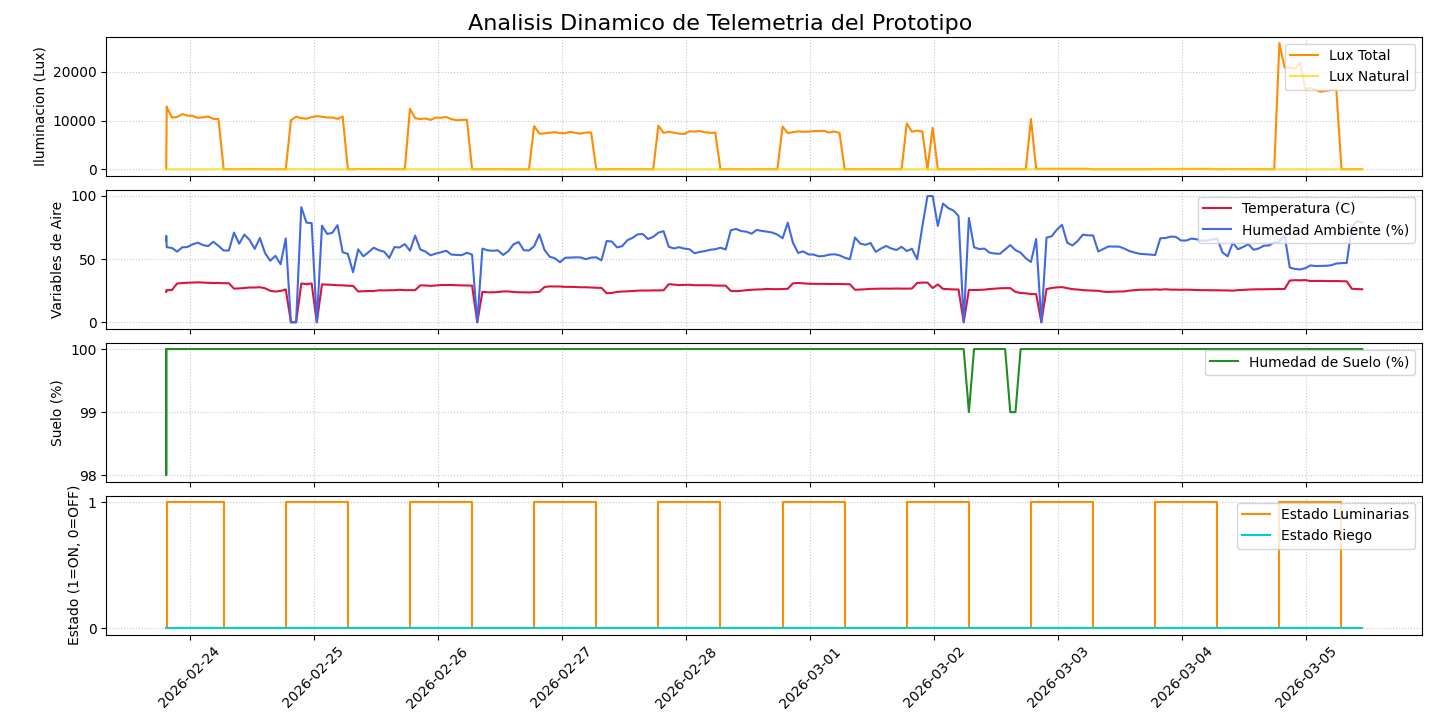
[picture p82: Informe/Imagenes/GraficoSegundaMedicion.png]
    
    \caption{Series temporales de la telemetría del prototipo: variables lumínicas, ambientales, de suelo y estados de los actuadores.}
    \label{fig:graficos_telemetria}
\end{figure}

\section{Resultados del prototipo final}

\subsection{Tercera prueba}
Una vez concluidas las fases preliminares de ensayo y habiendo validado la viabilidad funcional del modelo inicial, el desarrollo avanzó hacia la etapa de experimentación biológica en la infraestructura del prototipo final. Este entorno operativo consolidado presentó capacidades de acondicionamiento ambiental significativamente superiores, al integrar la bomba hidráulica para el riego automatizado, una configuración de doble luminaria por contenedor para optimizar el flujo fotónico, la red de sensores estabilizada y una mezcla de sustrato calculada para potenciar el desarrollo radicular. A continuación, se presenta el registro secuencial que documenta la evolución cronológica de las especies vegetales bajo estas condiciones optimizadas:

...fotos de las plantas...

A continuación, se presentan las representaciones gráficas de las series temporales correspondientes a las variables críticas para el desarrollo y sostenimiento del cultivo. Estas ilustraciones permiten analizar el comportamiento dinámico del sistema y evaluar la estabilidad frente a las perturbaciones del entorno.

...graficos y explicacion...
