alebeierbach/Proyecto-Integrador-PI/1er Prueba Rabanito/Mediciones/Primeras 24hs de medicion/Grafico (1).jpeg

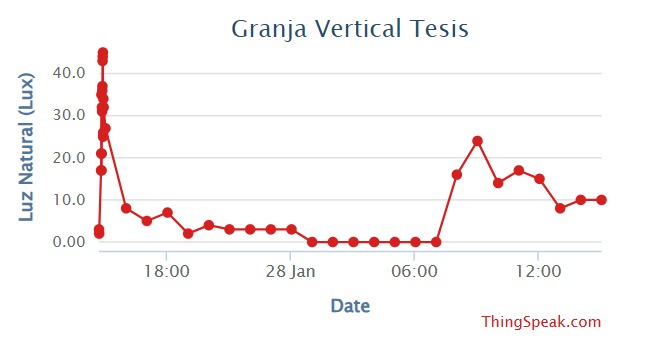
1er Prueba Rabanito/Mediciones/Primeras 24hs de medicion/Grafico (1).jpeg
