alebeierbach/Proyecto-Integrador-PI/1er Prueba Rabanito/Mediciones/Primeros 4d de medicion/Grafico (1).jpeg

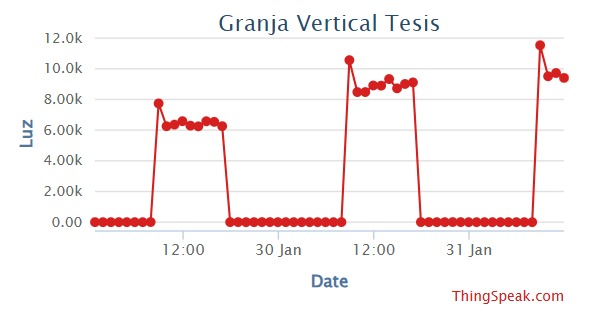
1er Prueba Rabanito/Mediciones/Primeros 4d de medicion/Grafico (1).jpeg
