alebeierbach/Proyecto-Integrador-PI/1er Prueba Rabanito/Prototipo de prueba/Prototipo v1 (3).jpeg

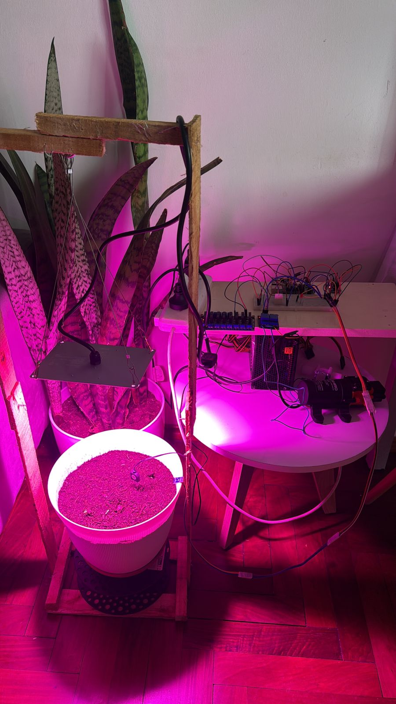
1er Prueba Rabanito/Prototipo de prueba/Prototipo v1 (3).jpeg
