alebeierbach/Proyecto-Integrador-PI/2da Prueba Rucula Espinaca/WhatsApp Image 2026-03-02 at 13.51.04.jpeg

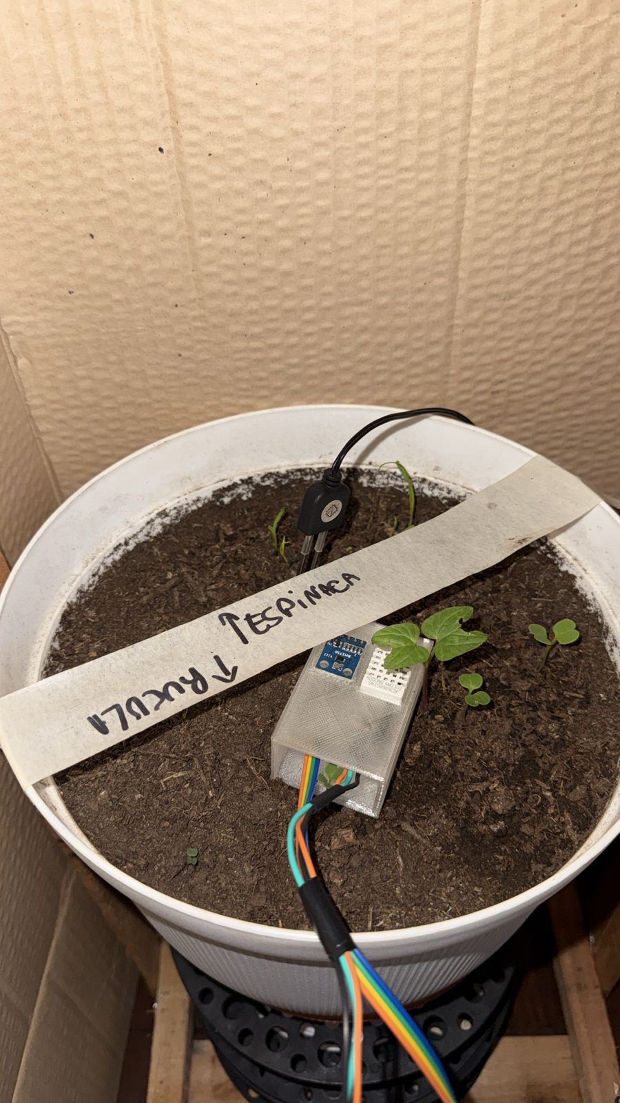
2da Prueba Rucula Espinaca/WhatsApp Image 2026-03-02 at 13.51.04.jpeg
