alebeierbach/Proyecto-Integrador-PI/(commit log)

2025-11-21 Solved issue about pump relay
    [PI1.0.py]
2026-03-30 Calculo de DLI a partir de lux
2026-05-27 Create config.toml
    Add configuration settings for global parameters, sensors, and actuators.
2026-05-29 Agregar carpeta con fotografias del desarrollo de los cultivos
2026-05-30 Add HardwareManager class for device control
